SK21/AOG_RC/Help/Raven flowmeter pin out.jpg

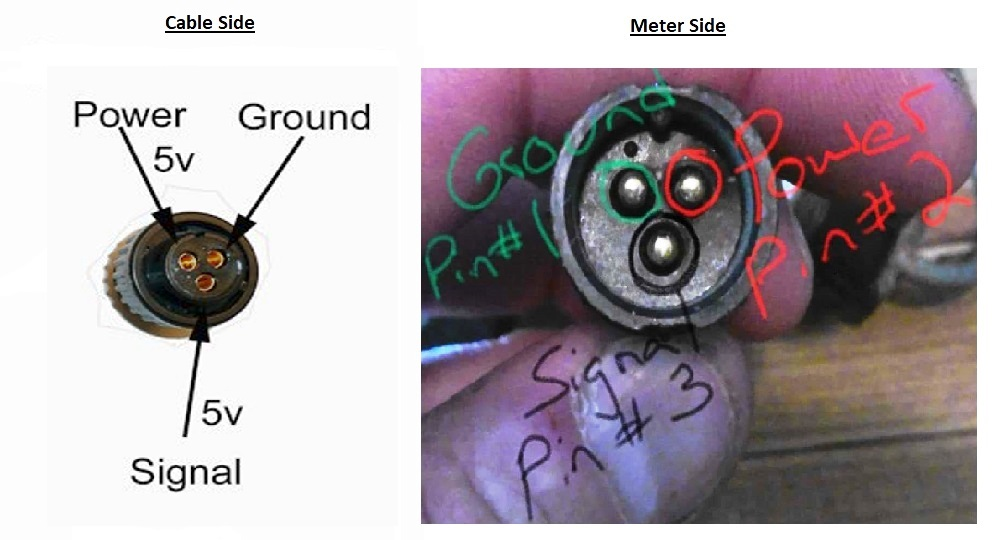
Help/Raven flowmeter pin out.jpg
