SK21/AOG_RC/README.md

RateController (RC) is an add-on app that works with AgOpenGPS (https://github.com/farmerbriantee/AgOpenGPS/) for product application rate control.

For more information see the Wiki.
