SK21/AOG_RC/Help/Schottky Diode/Notes.txt

Diode D2, LCSC# C116712

SS36 schottky diode in the power circuit has the anode end (+) to ground. 

cathode -     anode +
-----------|<-------
