SK21/AOG_RC/Help/Switchbox_PGNs.pdf

32618 32701
Switchbox to Rate Controller | Config from PCBsetup to switchbox

106 189

127 127

command | Auto
sw0 to sw7 | Master On
sw8 to sw15 | Master Off
CRC | Rate Up
Byte 2: | Rate Down
bit 0, - | Switches 1-16, bytes 7-22
bit 1, Master On | Work Pin
bit 2, Master Off | CRC byte 24

bit 3, Rate Up

bit 4, Rate Down

bit 5, Auto Section

bit 6, Auto Rate

bit 7, Work Switch
