SK21/AOG_RC/RateControllerApp/Help/frmMenuHelp.pdf

Troubleshooting
No Relays:

### 1. Is module config for board and relay type correct? 2. Subnet set in app? Uploaded to module? 3. Section count and width set? 4. Is Auto on? 5. Section assigned to relay? 6. Switch assigned to section?

7. If auto on, sensor counts/unit and base rate are needed.

No UPM:
1. Check speed.
2. Check working width.
3. Check sensor control settings.

### 4. AOG connected? 5. Module connected?

6. Check sensor counts/unit.
7. Check base rate.

### 8. Did the control values get sent to the module? 9. Control type, is it a valve or motor? 10. Connector fully plugged in? 11. Up to date version of module firmware? 12. Auto on?

No rate adjust:
1. In manual the master switch must be on.

### 2. Minimum pwm too low?

Motor won't shut off:
1. Minimum pwm should be 0.

### 2. Master override on?

After Updating firmware:
1. Resend subnet.
2. Resend module config settings.

Tips

- long press (right click) some screens, including the rate map, to drag to position. For the menu screen long press the icon in the top left corner.
- click on current rate to cycle rate display
- click on target rate to switch between target rate and alternate rate
- click on quantity to cycle quantity display
- click on quantity amount to reset
- click on coverage to cycle coverage display
- click on coverage amount to reset
- using the standard screen, click on AOG or MOD to minimize and display the rate only
- using the large screen, click on the graph to select a product
- on the options menu use ‘Single Product’ to arrange a minimal view of the large screen
