SK21/AOG_RC/RateControllerApp/Help/frmMenuJobs.pdf

Jobs

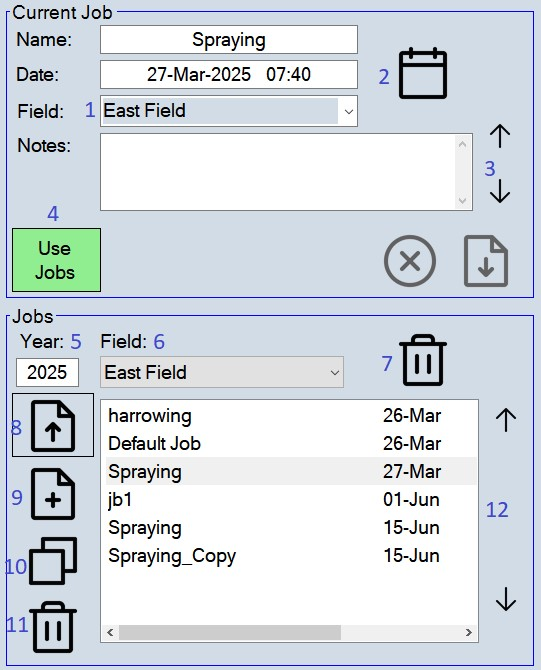
[picture p2: figure]

1. Field name. Select from list or type new name.
2. Insert current data and time.
3. Page up/down through notes.

### 4. If enabled allows the use of rate maps and storing

rate data.

### 5. Sort Jobs by Year 6. Sort Jobs by Field 7. Delete selected Field

8. Load Job.
9. New Job.

### 10. Copy selected Job information and rate map to a new

file.
11. Delete selected Job.
12. Page up/down through Job list.
