SK21/AOG_RC/RateControllerApp/Help/frmMenuPressure.pdf

Pressure

Take two readings to calibrate. Set to a known low pressure and enter the reading and the pressure. Do the same for a known high pressure. Enter the minimum reading for 0 pressure.

Press ‘Show’ to display the pressure screen.
