SK21/AOG_RC/RateControllerApp/Help/frmMenuConfig.pdf

Modules Config

### 1. Relays 0. no relays

1. GPIOs, use the micro-controller pins.
2. PCA9555, use 8 relay module.
3. PCA9555 , use 16 relay module.

### 4. MCP23017 5. PCA9685 6. PCF8574

### 2. Pins

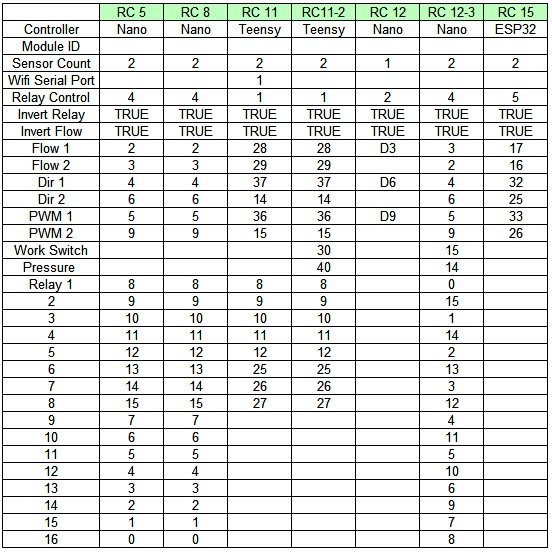
[picture p3: figure]

### 3. Nano Pins

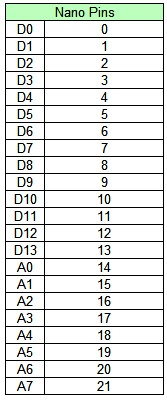
[picture p4: figure]
