SK21/AOG_RC/RateControllerApp/Help/frmMenuPrimed.pdf

Primed Start

Start a simulated product application or prime the booms when tractor is stopped. Using the switchbox master switch, hold in the ‘On’ position for the set delay time to enable primed start.

### 1. On Time

- Run-time for the application (seconds).

### 2. Speed

- Simulated speed.

### 3. Master switch delay

- The time to hold the master switch in the ‘On’ position to start the simulation (seconds).

### 4. Resume

- After the On Time finishes and if the tractor is moving continue with normal operation.
