SK21/AOG_RC/RateControllerApp/Help/frmMenuSwitches.pdf

Switches

### 1. On-Screen Switches

- Display on-screen switches.

### 2. On-Screen Dual Auto

- Display separate switches for auto rate and auto section control.

### 3. Work Switch

- Use a switch connected to the implement to control On/Off.

### 4. Auto Switch Rate + Sections

- Auto rate control and auto section control.

### 5. Auto Switch Sections

- Auto section control only.

### 6. Master Override

- Lock the master switch to on.
