SK21/AOG_RC/RateControllerApp/Help/frmMenuNetwork.pdf

Network

### 1. Rescan (circle)

### 2. Send subnet address to modules (up arrow)

The default values for each board can be loaded into settings.
