SK21/AOG_RC/RateControllerApp/Help/frmMenuRate.pdf

Rate

### 1. Product Name

### 2. Control Type

a. Standard Valve
- use a valve to vary rate
b. Combo Close
- use a valve to vary rate and on/off
c. Motor
- vary motor speed to control rate
d. Combo Timed
- use adjust/pause time for control

### 3. Quantity Units

- units used to measure product

### 4. Coverage Units

- Acre, Hectare, Minute, Hour

### 5. Sensor Counts/Unit

- sensor counts for each unit applied

### 6. Density

### 7. Base Rate

- application target rate

### 8. Alt. Rate (%)

- an alternate rate as a % of the base rate

### 9. Tank Size

### 10. Tank Start

- amount in tank at start of application
