SK21/AOG_RC/RateControllerApp/Help/frmMenuSections.pdf

Sections

### 1. Copy Button

- Copy width from section 1 to the other sections.

There are 16 sections to a module and up to 8 modules. Module 0 sections are 1-16, Module 1 are 17-32, etc. Sections can be defined individually or within zones. All sections in a zone are the same width. All sections in a zone are controlled with one switch. AOG can still auto control each section individually.
