SK21/AOG_RC/RateControllerApp/Help/frmMenuRateData.pdf

Applied Rates Data

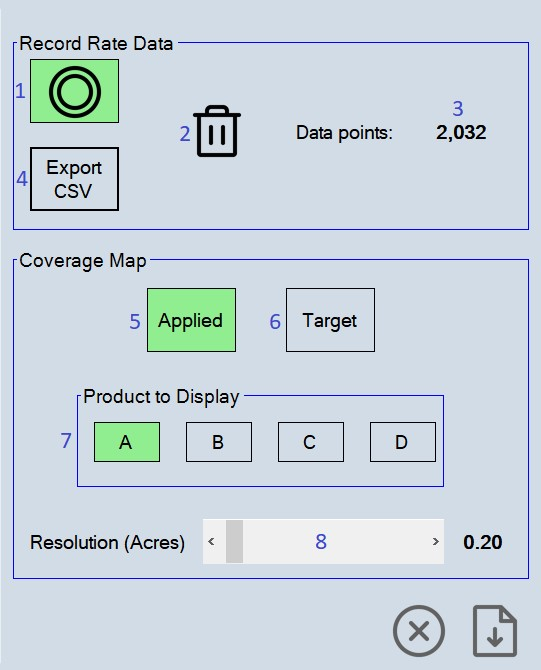
[picture p5: figure]

1. Enable recording.
2. Delete recorded data.
3. Number of data records saved.
4. Copy rate data to a file.
5. Show Applied rates on map.
6. Show Target rates on map.
7. Choose product rates to show on map.
8. The size of the area to average the rates in acres or hectares.
