SK21/AOG_RC/RateControllerApp/Help/frmMenuRateMap.pdf

Rate Map

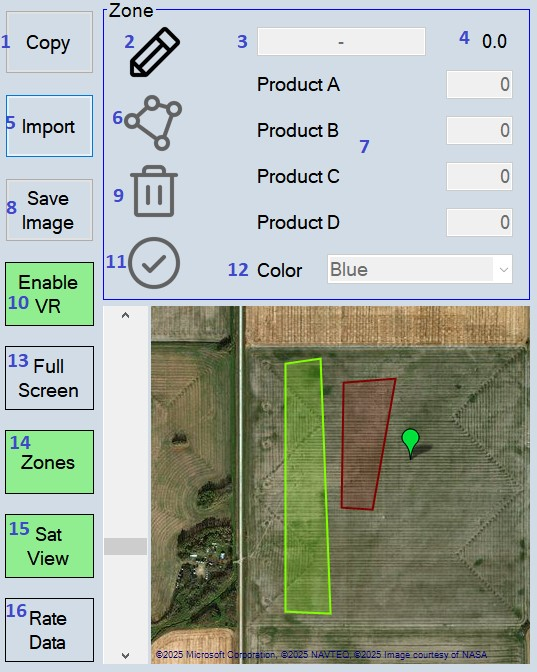
[picture p6: figure]

1. Copy rate map from another job.
2. Edit rate zone.
3. Name of zone.
4. Area of zone in acres or hectares.

### 5. Import

- Press the Import button to open the Import form. Load an alternative type of shape file using the up-arrow on the Import form. The form will list the RC attributes on the left. Use the drop-down box to the right of each RC attribute to cross reference from the alternative file attributes. Use the down-arrow on the Import form to save a new RC shape file with these cross referenced attributes.
6. Edit polygons.
7. Product rates.
8. Save an image of the map to file.
9. Delete zone.

### 10. Enable VR

- Enable variable rate control. Each product uses variable rate control. All zones must define a rate for each product used.
11. Save zone edits.
12. Zone color.
13. Full screen view.
14. Show zones overlay.
15. Show satellite view.
16. Show rate data overlay.
