SK21/AOG_RC/RateControllerApp/Help/frmMenuProfiles.pdf

Profiles

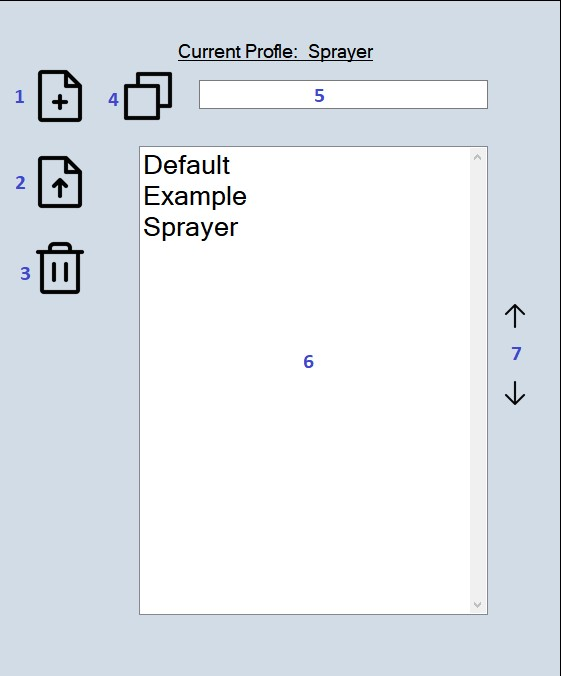
[picture p7: figure]

1. New | 2. Load
3. Delete | 4. Copy
5. File name for New/Copy | 6. Files to select
7. Page Up/Down
