SK21/AOG_RC/Help/MCP23017_Pins.PNG

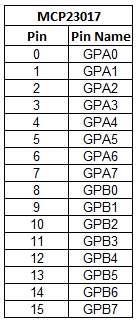
Help/MCP23017_Pins.PNG
