SK21/AOG_RC/Help/Schottky Diode/C116712.PNG

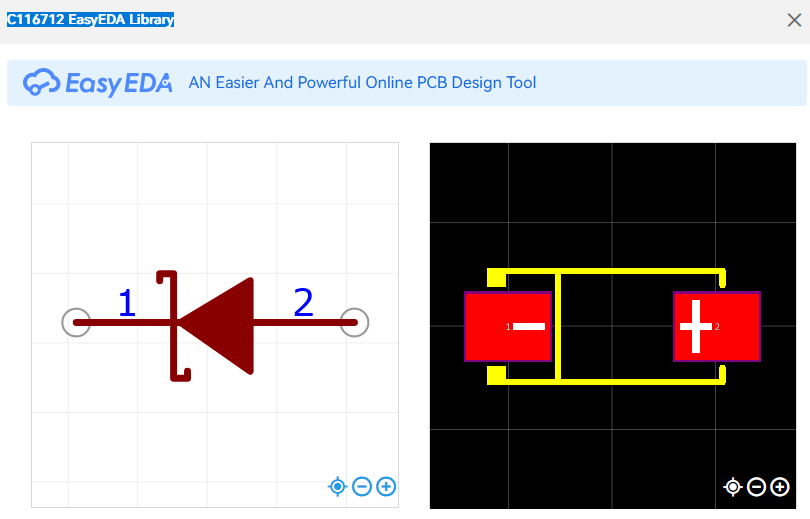
Help/Schottky Diode/C116712.PNG
