SK21/AOG_RC/Help/Schottky Diode/Circuit.PNG

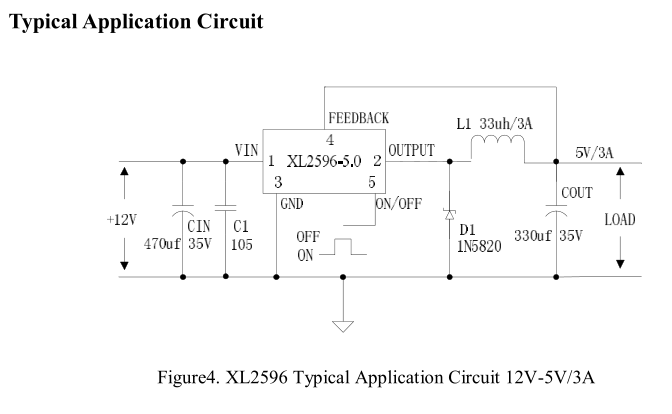
Help/Schottky Diode/Circuit.PNG
