SK21/AOG_RC/Help/Schottky Diode/SS36.PNG

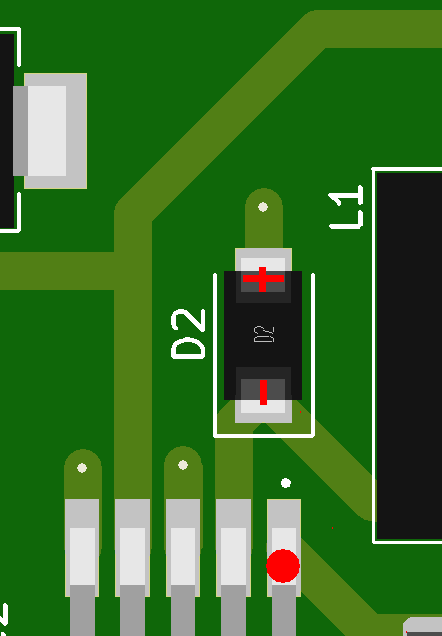
Help/Schottky Diode/SS36.PNG
