SK21/AOG_RC/RateAppSource/RateController/Resources/2wire.png

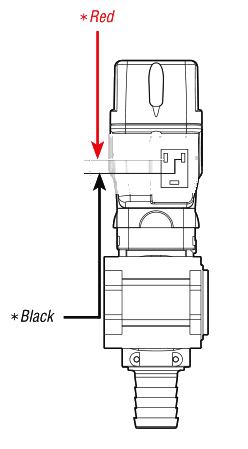
RateAppSource/RateController/Resources/2wire.png
