SK21/AOG_RC/RateAppSource/RateController/Resources/3wire.png

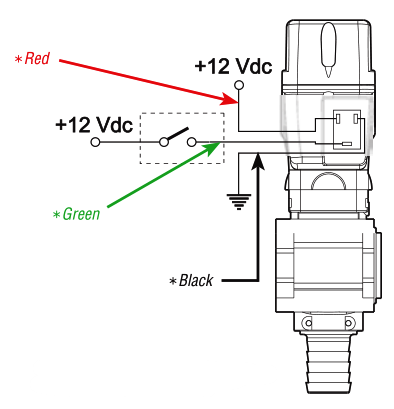
RateAppSource/RateController/Resources/3wire.png
