SK21/AOG_RC/RateAppSource/RateController/Resources/Pins1.PNG

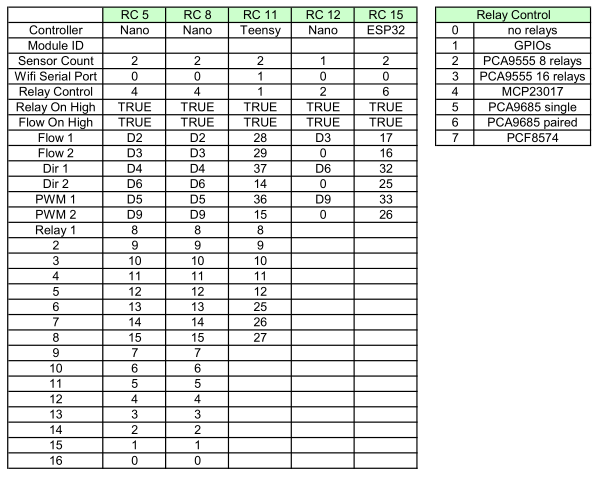
RateAppSource/RateController/Resources/Pins1.PNG
