SK21/AOG_RC/RateAppSource/RateController/Resources/Pins.PNG

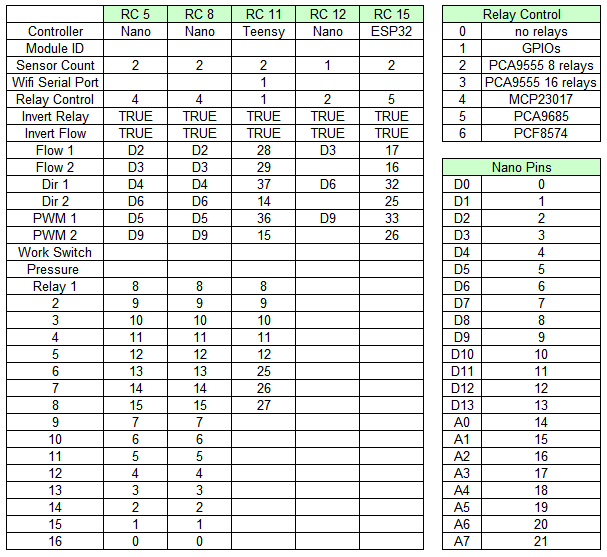
RateAppSource/RateController/Resources/Pins.PNG
