SK21/AOG_RC/RateAppSource/RateController/Resources/Valve2wire.png

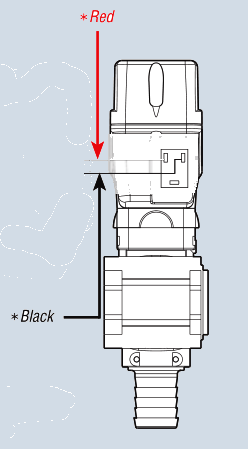
RateAppSource/RateController/Resources/Valve2wire.png
