SK21/AOG_RC/RateAppSource/RateController/Resources/Valve3wire.png

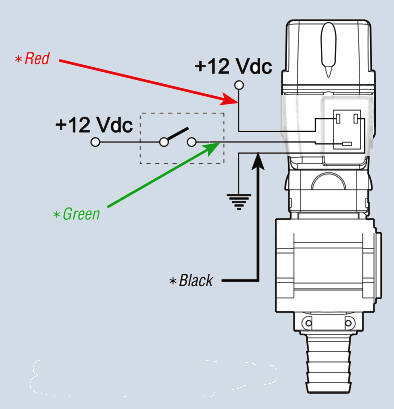
RateAppSource/RateController/Resources/Valve3wire.png
