SK21/AOG_RC/RateAppSource/RateController/Resources/x-bold.png

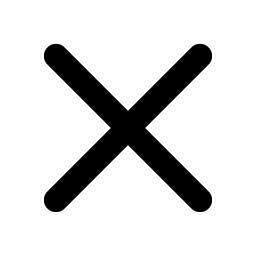
RateAppSource/RateController/Resources/x-bold.png
