SK21/AOG_RC/(threads)

Thread 1 (2020-02-13):

Broken link

ikidd, 2020-02-13:
Reorg of folders broke the links in your ratecontroller repo.

SK21, 2020-02-13:
Ok I'll fix it.

Sent from my BlackBerry — the most secure mobile device — via the SaskTel Network
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

Closed 2020-03-23.

Thread 2 (2021-01-30):

Restructure repository

mirh, 2021-01-30:
Can you purge all the binaries from git, and just attach them cleanly and neatly in the release section (bundled together or separately)?
Putting aside they make sources quite heavier, even if you half-way understand their working it's a mess to go back and forth between their folders.

SK21, 2021-01-31:
I can see where it is 'heavy'. I just downloaded the zip file. It is over 100 MB. So what your saying is to create a release and move the supporting files to there. Then just the updated install can be downloaded. The supporting files can be downloaded separately if needed.

mirh, 2021-01-31:
And move the binaries to the release section, yes.
I'd also recommend to bring in the [.gitignore](https://github.com/farmerbriantee/AgOpenGPS/blob/master/.gitignore) file from aog to avoid "forgetting" stuff when pushing.

Btw is "100" and "200" supposed to be a version number, or what?

SK21, 2021-02-02:
Yes a version number.

marshalab, 2021-02-03:
Sorry for the stupid question. I'm a newbie trying to figure out a lot of forks AgOpenGPS.
And where are the device diagrams for your development? Or is iron described elsewhere?

thanks

SK21, 2021-02-05:
Any of the pcbs will work with RateController. The 10 pin network header on RC4 needs more 3.3V current than the nano can provide. The nano clone here might work. https://www.seeedstudio.com/Seeeduino-Nano-p-4111.html A better option may be to use a Nano ethernet shield if you are connecting that way.

mirh, 2021-02-05:
Cool.
Would it be possible to get some logical schematics like [this](https://github.com/Coffeetrac/AG_Rate/blob/master/AGRate_Schematics.jpg) or [this](https://aws1.discourse-cdn.com/free1/uploads/agopengps/original/1X/199a6c959acedecaec6603bb8612be2a2adf76c6.jpeg)?

I'm not sure what I need in addition to arduinos, a flowmeter and the controllable valve/PID controller

SK21, 2021-02-06:
Here are some schematics.
[RC schematic.pdf](https://github.com/SK21/AOG/files/5937063/RC.schematic.pdf)
[schematic.pdf](https://github.com/SK21/AOG/files/5937065/schematic.pdf)
[AOG schematic.pdf](https://github.com/SK21/AOG/files/5937066/AOG.schematic.pdf)

mirh, 2021-02-06:
Thanks, that was really helpful! (even though still not the same cakewalk of the normal dokuwiki instructions for autosteering)
I only need the motor driver then now.

Why is there a capacitor on the flow input trace though? My plan was just to connect the spare components in a fancy box without the pcb.

SK21, 2021-02-06:
On one tractor I found a lot of noise on the signal. The capacitor seemed to clean it up.

mirh, 2021-03-09:
Uhm, well, now the repo is quite cleaner. Thanks.
Is there any way to control a "master" machine switch though?
It seems wasteful to turn off all sections independently when you get at the end of every line.

Closed 2021-03-09.

Thread 3 (2021-03-07):

RC4 PCB and parts lists?

ikidd, 2021-03-07:
I think I've looked through everything, but can't find the PCB sections and the parts lists?  Am I just blind?  In another copy of the repo I have a top level folder called RateController100 with them inside, but I was checking if there were any changes to what I have and can't find anything in the current version of the repo.

SK21, 2021-03-07:
You can find it under releases, version 1, other files. There is no changes to rc4.

Sent from my Galaxy

-------- Original message --------
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

joshwilsonfarms, 2021-04-01:
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
Is there anyway to incorporate rate control in to my section control system without using the PCB you have listed?

SK21, 2021-04-16:
You would just have to change the pin assignments to match your setup.

Closed 2021-05-03.

Thread 4 (2021-04-15):

Use without I/O extender?

mirh, 2021-04-15:
I have a nano, and a board with 8 DPDT relays (and I should only need 5 of them).
Is it possible you could add a switch case or alias to the mcp functions, to use the normal pinMode/digitalWrite optionally?

(btw, for maximum noobproofness, I guess you could even add a comment on line 80 of RCarduino.ino to point out that in case of error users should download the right library from the manager in the arduino ide tools section)

SK21, 2021-04-16:
I can add code to use RCarduino without a I/O extender.

mirh, 2021-04-16:
Cool, thanks.
I have more questions than answers though now.

Why did you switch to the analog pins?
And why only 4?

SK21, 2021-04-16:
The analog pins are the same as digital pins. If someone is using a ethernet shield those pins are not being used. The ethernet shield uses pins 7,8,10,11,12,13. You can change it to whichever pins are free.

SK21, 2021-04-16:
Pins A6 and A7 are input only and won't work for relays.

mirh, 2021-04-16:
Right, I see the comment.
Though now, something else is escaping me.

With your vanilla code, I'm getting relays at D2, D3, D4 and D6 to turn on, and I cannot seem to do anything else with the thing.
If I adjust the code for Relay# to go from 2 to 9, I only get D4 and D6 to light up, and again I cannot seem to toggle them.

Once put aside my lack of control, the FlowDir array seems to be the deciding factor... But I'm not sure how I'd be supposed to control n sections when the code (even for the MCP23017 case) has just two pins there.
Sorry if I'm making overly dumb questions.

SK21, 2021-04-17:
For  FlowPin, FlowDir, and FlowPWM, the first element of each array is for one product. The next element of the array is for another product. For the first (or only) product the first element of the FlowPin is connected to an interrupt and senses the flow. The FlowDir and the FlowPWM are connected to the motor controller to open or close the control valve.

How are you turning on the relays? Are you using the RateController app? Might be a setting in that.

mirh, 2021-04-17:
Duh, right. I hadn't completely configured RateController, and it wasn't working. Or maybe it was just that (*understandably*) I had to \*move\* the tractor in the simulator for the section switches to turn on at all.
I still have a couple of remarks though:
* it should be pointed out that AgIO has to be kept open for RC to hook it (it may be obvious when it's AOG to handle the machine port, but given here the serial port doesn't have to be hooked there, it's confusing)
* I can [half-way](https://github.com/SK21/AOG/blob/2.1.3/RC%20Source/RateController/FormStart.cs#L209-L218) guess what that salmonish "SimColor" hue for *Mod* means, but if I were out there in the field I could hardly see that shade (let alone figure out if it's just an innocent warning, or something I should quite be worried about)
* just to check, is it normal switching to "fast close valve" has D5 and D6 always turned on, while switching to "motor" has only D6?

SK21, 2021-04-17:
AOG only connects to AGIO, so yes AGIO needs to open. But then to use AOG, AGIO needs to be open anyway.

In the field the simulator should be off, so Mod with be either red or green. Also in the product detail the heading shows if it is in simulation mode.

If D5 and D6 are for relays, changing the valve type shouldn't affect whether the relays turn on. Make sure D5 and D6 aren't assigned to anything else such as PWM or DIR.

mirh, 2021-04-17:
Makes all sense now, after seeing the SensorCount loops I think I got the point of the arrays arranged this way.
Thanks very much.

mirh, 2021-04-20:
Ok in retrospect I don't think I have actually understood them.

I only have one sensor.
But I can't only write a single pin for flow and pwm in the arrays, because SensorCount is 2.
And if I lower it to 1, then hell break loose across many files.

I can easily see the 0s and 1s with arduino's [InputPullupSerial](https://www.arduino.cc/en/Tutorial/BuiltInExamples/InputPullupSerial) example on D3, but I cannot get ratecontroller to understand it.

Closed 2021-04-17.

Thread 6 (2021-04-28):

Program is dead without AOG

mirh, 2021-04-28:
So.. after much tinkering (somehow, I had completely missed we are working on baud 38400) I got to read your program data inside the arduino IDE.
The problem is I'm only getting `127,101,0,0,0,0,0,0,0,0` or `127,101,1,0,0,0,0,0,0,0` as returned values, forever.
Do I need to use RateController to have actual feedback back?

And even then, am I supposed to do anything else besides setting simulation to off?
I tried to connect my flow meter to either of the FlowPins (that I checked to get the correct signal with a simple code sample), but no matter what I do, calibration never senses a single count.

SK21, 2021-04-28:
You need RateController for the ino to work. Set simulation off. If you are connecting with serial use one of the connections on the comm page. The green light should come on.
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

Also the Mod indicator should turn green.

On the Products/Options for the product you are using the Module ID and Sensor ID should be 0. The indicator should be green.
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

The Products/Diagnostics tab will show any flow signals as UPM Applied. The tractor will have to be moving and sections turned on. Make sure the sections widths are entered again in RateController even if they are already entered in AOG. Make sure on the tab Products/Options the sections you are using have a check mark.

On the Products/Rate tab the Sensor Counts/Unit needs to be entered. Whether you use VCN or PID press the Load Defaults button.

mirh, 2021-04-29:
:\
Everything I had to do was opening AOG, not even the tractor moving, and it works now.

...

I get why a lot of things requires the main program open, but why is that also "hard blocking" of UPM applied and sensor counts?

SK21, 2021-05-01:
Yes that could be done as well.

SK21, 2021-05-02:
Have you tried receiving the pulse counts without AOG?

mirh, 2021-05-03:
Yes, that's what I was banging my head against in the first post.

SK21, 2021-05-03:
See if it works now.

mirh, 2021-05-15:
Perfect now, thanks!

Closed 2021-05-15.

Thread 7 (2021-05-01):

Relay control over serial?

mirh, 2021-05-01:
Sigh, I can't understand if I'm always here complaining because I'm one of the few people that got at least half-way of training in both AG and ICT, or if I'm just a bane of intelligence.

How are you supposed to control relays from AOG, if RC takes full ownership of it?
I mean, I see the code to control them is there, but nothing triggers when I click on the various sections.

Or is this only a limitation I brought upon me when I decided USB/serial was good enough for me?

SK21, 2021-05-02:
Serial and UDP work the same. If you mean controlling the sections with the on-screen buttons of AOG, then yes these should work. The sections should be able to be controlled from either the on-screen buttons or from remote physical switches. If you have physical switches that are turned off, these take precedence to make sure sections stay off. If you don't have physical switches then it is set to auto mode where the on-screen buttons should work.

SK21, 2021-05-02:
The on-screen section buttons previously only worked in RC auto mode. They now work in manual mode as well.

mirh, 2021-05-03:
***Well***
I'm glad you found a potential bug (I didn't notice it)
But it turns out I had just forgot I had stolen the +5V/GND cables from the relays to power the flowmeter. 😓

Closed 2021-05-03.

Thread 9 (2021-07-30):

Some hardship on adding more relays

mirh, 2021-07-30:
Soo.. As usual I'm with my Nano, connected with a simple usb cable.
Everything was fine and dandy, until I tried to go past the 4 relays that the "Nano pins" codepath defaults to.
I uncommented the pinMode for Relay5 to Relay8, then same for their defines, and last but not least I set them to follow the natural progression from A4 to A7
But for some reason I can still only control the first four usual relays (and yes, I did set 8 sections in both RC and AOG)

---
p.s. I also found great.. puzzling when it came to interpreting this line.
https://github.com/SK21/AOG_RC/blob/f1fbfcb5fb170020fd8f94c0bf1c1fda9da2faf9/RCarduino/RCarduino.ino#L28
Could it be named to something like *UsePhysicalSwitches*?  Also, the comment could maybe be changed to "1 to use commands from hardware switchboard"

SK21, 2021-07-30:
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

Did you set the switch # for each of the other sections? Do you have 8 switches? If not one of the existing switches that you have can control some of the new sections.

I don't think A6 and A7 will work. They are input only on a Nano.

Line 28 attempts to clarify whether the switches used to control the sections are connected (local) to the rate PCB or are the switches on a separate pcb dedicated to switches or the sections are controlled on-screen. 0 means no switches connected to the rate pcb. 1 means switches are connected to the rate pcb.

SK21, 2021-07-30:
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

Also need to uncomment lines 35 to 38 of the Relay.ino

mirh, 2021-07-31:
Perfect, that was it!
(I wonder if it couldn't be made a bit more obvious? perhaps already just with a comment)

> Line 28 attempts to clarify whether the switches used to control the sections are connected (local) to the rate PCB or are the switches on a separate pcb dedicated to switches or the sections are controlled on-screen.

Yes, I had eventually imagined you were aiming for something like [this](https://www.youtube.com/watch?v=kI321iBwe4U) or [this](https://www.youtube.com/watch?v=K2U5_X6FHQg).
It's just.. I don't know, that wording isn't the clearest label on the shed.

Closed 2021-07-31.

Thread 10 (2021-08-18):

Relay-controlled valve

mirh, 2021-08-18:
Long story short, my flow valve has a motor that works with polarity reversal.
And through the power of DPDT switches, we could just say it has two commands/states: "more" and "less".

I tried to half ass together something in *Motor.ino*, but clearly there's so much more to it.
Would it be too hard and disruptive to add support for this?

SK21, 2021-08-18:
Are you using the motor option or the standard valve?

mirh, 2021-08-18:
I tried to tinker with the standard valve code, after having retooled the PWM pin to be just a digital one outputting the opposite of the direction state... but it kinda failed.
But I think this would be worth a new type of motor tbh (is "proportional" even the right word? I have no control on the velocity, maybe "linear valve" would be better?) since nothing in the PID settings tab would apply.

SK21, 2021-08-19:
I am not clear on how your motor works. A standard valve has more and less commands. The motor control varies the voltage from 0 to 12 v.

Do you have a model # or link to a page about the motor?

mirh, 2021-08-19:
I have [this brochure](http://www.bertolinipumps.com/irrorazione_accessori/cp_mot.pdf#page=2) (last one) about the body, and [this](http://www.bertolinipumps.com/prodotti/cataloghi/catalogo-multiduplospray.pdf#page=2) should be the valve-only.

> A standard valve has more and less commands.

Yeah, but you also have PWM to regulate speed, while "effect direction" is the state of a single relay.
Here instead, you just supply +12V or -12V (which at the end of the day I made to correspond to two separate relays) and that's about it.

SK21, 2021-08-21:
In the last brochure about the valve it looks like the motor only controls on/off, not flow.

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

mirh, 2021-08-21:
It's on/off in a sense, yes.
But the "obturator" can end up sitting in more than just two states, if I can explain.
And this way (since polarity reversal makes for *two* separate "ON" eventually) you can control flow.

bduncan175, 2021-09-17:
It sounds like his valve is similar to a standard raven flow control valve that is plumbed as a bypass system, but can also completely shut off. https://www.spraysmarter.com/raven-precision-1-poly-control-valve-flanged.html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

mirh, 2021-09-17:
Sorry, I snafued the valve brochure. [This](http://www.bertolinipumps.com/prodotti/cataloghi/catalogo-serieviking.pdf#page=1) should be the right one.
To reiterate again: with +12V (i.e. one relay) the ball rotates in one direction, with -12V (an other relay) the opposite one.

SK21, 2021-10-04:
So you would like to control the pressure with 2 relays, one for increase and one for decrease? A motor controller would not be used. I could change the code to add another control type that would use relays instead of a motor controller.

Motor.ino:
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

SK21, 2021-10-04:
Should be:

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

SK21, 2021-10-05:
It could also work with a motor controller if the PWM is set to maximum. This would give 12V.

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

mirh, 2021-10-07:
> A motor controller would not be used.

I think the confusion is due to the valve mechanism technically having one, but the DPDT wiring I used making it logically be just two switches (I mean, I'm not sure how else I could have controlled polarity inversion otherwise).

***Anyhow***
```C
// use 2 relays for flow control
if (FlowEnabled[i])
          {
              if (pwmSetting[i] > 0)
              {
                  // increase
                  digitalWrite(FlowDir[i], 1);
                  digitalWrite(FlowPWM[i], 0);
              }
              else if (pwmSetting[i] < 0)
              {
                  // decrease
                  digitalWrite(FlowDir[i], 0);
                  digitalWrite(FlowPWM[i], 1);
              }
              else
              {
                  // no change
                  digitalWrite(FlowDir[i], 0);
                  digitalWrite(FlowPWM[i], 0);
              }
          }
          break;
```
was exactly what I needed (at least when I replaced the fast close valve block for testing purposes).
The only thing is.. since this has no derivative control, at least when near the target rate shouldn't you have some kind of margin of tolerance to not flip-flop forever the relays?

mirh, 2021-11-01:
Thank you so much!
With combo close now everything is just right (I still have some idea for target rate adjustments on-screen buttons, and hooking the "master valve", but that will be for another time I guess)

Do you accept donations by any chance?

mirh, 2023-04-12:
Ok well, I quite literally just re-repeated the code above and it worked this time.
If the merit wasn't to be with some of your latest commits, I suppose it could be with me possibly having mixed up the pin numbers due to the different order the original lines have.
https://github.com/SK21/AOG_RC/blob/feeb3e6a7ddbb1c69c3beb8bc7b5be15e5b7a55b/Modules/Nano/RCnano/Motor.ino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
The only "novelty" is that I also have to remember to set _PWM maximum_ to 255.

mirh, 2023-04-29:
I don't know if this couldn't be an offshoot of #30, but as if it wasn't enough I cannot get the Every Nano to respect that
```
  // no change
  digitalWrite(Sensor[i].DirPin, 0);
  digitalWrite(Sensor[i].PWMPin, 0);
```
bloody code.
Once the pin turns on once, it doesn't shut up until I disconnect the communications (or well, I enable auto mode *\_-\_*).

mirh, 2025-04-27:
I'm once again in need of a hand with this more/less valve.
Ever since 2.3.6~2.3.7 (I'm gonna guess due to the different way the deadband and other calculations were changed?) the relay that should increase the flow rate keeps staying on even when the implement is turned off.
And starting from 3741da803d9b6d49f46cb74d0c5ecd4aff446a49 it's instead just dead.

Thread 11 (2022-02-02):

Extra headers aren't optional

mirh, 2022-02-02:
https://github.com/SK21/AOG_RC/blob/fe67227c4d8c57f762458e546be5b60ef9889aad/RCnano/RCnano.ino#L1-L2

Of course they wouldn't be needed when you are just using the arduino pins, and when you aren't using udp, respectively.
(yes it's a miserably small issue since you can just delete the two lines, but still)

SK21, 2022-02-03:
I don't believe they cause that much trouble if left included. They could be commented out if necessary.

mirh, 2022-02-03:
I was thinking you could put the includes below the user settings, and guard them with ifs, but I guess it's a pedantic trifle.

Closed 2022-02-03.

Thread 12 (2022-02-02):

Master valve support

mirh, 2022-02-02:
I didn't really want to bother you with yet another "personal customization" request, but I just noticed `UseSwitchedPowerPin` seems kinda half-way it already.
You would only need to move it from "per whenever the system boots up" to "per actual usage" (i.e. whenever there is at least a section turned on)
This would be particularly helpful wear-wise, so when you reach the end of the crops row or when you manually toggle all sections, you don't have to "strain" n-th relays and valves but just a single one.

SK21, 2022-02-03:
As it was originally intended this change would not work correctly. This could be implemented on a per user basis. The code could be modified to fit your needs.

mirh, 2022-02-03:
What was the original purpose then? Something other than pulling open some master switch?

SK21, 2022-02-04:
It was to provide power for the rate control valve.

mirh, 2022-02-04:
Oh, I see, as opposed to a valve where control and power are on the same line. Sorry.
Well then, my feature request still stands.

Whenever work is being done you would have such relay enabled, and when an "action" would entail that no section is powered anymore you just leave them alone, and instead toggle this.

SK21, 2022-04-09:
In the Dev branch the Rate App will now do Master relay. On when sections are on, off when all sections are off and the section relay aren't moved.

mirh, 2022-05-08:
Sorry for the delay.. lots of bad stuff going on.
But I'm quite lost with the new rewrite of the arduino sketches (I can sense perhaps you wanted to simplify/unify the MCP/nano-only cases, but comments seem skewed just for the former now).
Where would I even specify the "master relay"? I don't see any such entry in the PCBpinConfig struct, nor I could spot any code designed for this functionality.

p.s. as I already said plenty of times, please add [some](https://github.com/github/gitignore/blob/main/KiCad.gitignore) [gitignore](https://github.com/github/gitignore/blob/main/VisualStudio.gitignore) to the project. The repository is just so heavy.

SK21, 2022-05-14:
Master relay is set in the rate app under the menu option relays. On the relays page you choose the type of relay. Section, slave, master, power or Invert_Section.

mirh, 2022-09-20:
Ok sorry again.. When I found new time for tinkering, I eventually had instead to debug some big annoyance with AOG itself.
What to say then?

Your PCBsetup app is pretty nice, but I have been banging my head for a day about what I should do for RC to work.
Should I upload with the arduino IDE the sketches in the modules folder as usual? Is PCBsetup supposed to take care of that too? Is the whole design even supposed to work with just a bare Nano?
Because no matter what I tried, the `Mod` indicator doesn't light up.

I know something ***is*** happening because every time I connect or disconnect from the Comm window, I can hear the relays clicking.. But red colour doesn't seem good.
Btw the monitor in your test app gets stuck at "tarting I/O Expander" (sic.)

SK21, 2022-09-22:
Is it the timing in AOG that you had to debug?

PCBsetup can load the firmware and the settings. It is meant to be used instead of an IDE, so no knowledge of programming is required. The IDE can be used if preferable.

I just erased a Nano with a blank sketch. Then I used PCBsetup to upload the Nano rate firmware. It showed fine in the serial monitor.
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

I connected the Rate App to the Nano comm port, ran AOG and started a field. Mod turned blue and then green. Blue indicates the module is sending but not receiving.

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

Have you tried uploading the Nano rate firmware? You may need to switch bootloaders.

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

mirh, 2022-09-22:
> Is it the timing in AOG that you had to debug?

https://github.com/farmerbriantee/AgOpenGPS/issues/264

> Have you tried uploading the Nano rate firmware? You may need to switch bootloaders.

I also did that.
*Modules* with the IDE, the default from pcbsetup, and even the latest .ino.hex from *Resources*.

It doesn't change anything.
In serial monitor, I only see `RC Nano : 17-Jul-2022` (every time) and then once every n attempt, there's some random part of the string "Starting I/O Expander".

Btw when I tried "use old bootloader" it almost seemed like I had bricked the arduino, and I could only recover from the IDE.

SK21, 2022-09-22:
I am not sure what else you can do. Does uploading the "Blink" sketch from the IDE examples work?

mirh, 2022-09-22:
:\\
No? I don't have any wemos (or pcb for all that it matters).
Where is that even mentioned? And why would ethernet be required even if the corresponding button isn't selected?

SK21, 2022-09-22:
The wemos on the pcb connects to Nano rx/tx. These pins are also used by the usb connection. The ethernet shield doesn't use rx/tx so there is no conflict.

If you don't use the wemos then there can be no comm conflict.

mirh, 2022-09-23:
"Comm" is just fine indeed (be it in the namesake RC window, or the two green lights in pcbsetup).
I don't have any wi-fi or ethernet, I'm not getting conflicts.
I just have literally a Nano and a straight usb cable to pc. Is this not supposed to work anymore?

SK21, 2022-09-23:
Yes usb will work. I just tried it in the previous posts. Just a nano and a usb cable.

mirh, 2025-04-27:
Since 3.7.9, when I stop the sections (that is, all of them together like with the button in AOG) rather than just the master relay turning off, every single one of them switches.

Closed 2023-02-26.

Thread 15 (2022-09-25):

PCBconfig struct needs extra member for Nano to work

mirh, 2022-09-25:
So.. Proceeding from https://github.com/SK21/AOG_RC/issues/12#issuecomment-1256272563, I found out eventually that if I add back `uint8_t CommType = 0;` (even to the latest master) I can finally get some output at last.
With some tinkering I ascertained that the name or the value don't really matter (obviously, it's not like the thing is still used somewhere), the magic trick is just adding "something".

    101,127,16,0,0,0,0,0,0,0,0,0,244

`lbArduinoConnected` is still red then to be fair, but I didn't really followed through considering the big mystery that this nightmare bug is.

SK21, 2022-10-01:
What kind of output are you getting?

mirh, 2022-10-01:
The one in the preformatted code block (repeated over and over again as you would expect).
Previously I was just getting the InoDescription line and then nothing else.

SK21, 2022-10-03:
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

For something to try change line 157 to some other number than 2388.

SK21, 2022-10-04:
So it must have been old data in the eeprom from a previous version that caused the problem. Changing the identification # for the data causes setup to use the default values instead of the ones in the eeprom. Then these default values are saved to the eeprom.

mirh, 2022-10-05:
Daamn... it's really facepalmy that it wasn't a905b8e1699570078a962c9ac47ed35eb792e4f3 to break everything then.
Yet again thank you (maybe you could change the identifier from time to time)

mirh, 2023-02-18:
Ok so.. Good that you actually seem to update it each time you update the code.

But  is it normal that every single time I use PCBsetup to update the firmware.. the damn thing goes haywire (i.e. you can see serial monitor spitting out garbage or half-lines) and only if I upload the inos with `InoID` manually changed I can get anything done?

SK21, 2023-02-18:
Which previous ino did you have loaded in the nano? Could you send me it so I can try to reproduce this problem?

mirh, 2023-02-18:
At least going all the way back to a year ago, I have never used inos other than your own on my nano.
And honestly this has been happening for every version since the introduction of PCBSetup.

Not that I'm unhappy now (after taking two whole weeks in https://github.com/SK21/AOG_RC/issues/12#issuecomment-1255446847 and following, if you remember) just knowing that I need some elbow grease to compile the code to get it setup.
But still, it's bewildering that the eeprom just cannot seem to behave.

To sum up again: if I load the firmware with PCBSetup I can only get garbage in return.
If I load [this](https://github.com/SK21/AOG_RC/tree/master/Modules/Nano/RCnano) from the IDE (and god forbid I didn't change the identifier, at least after having tried with PCBSetup) all is relatively fine and well.
...
Is RateNE_ino.hex even rated to work in the PCB-less case? ([this](https://github.com/SK21/AOG_RC/blob/69834b8d2abaa0395d5aceaf03d6fdc9e44f863d/PCBsetupSource/PCBsetup/Forms/frmAbout.resx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) line seems particularly suspicious tbh)

SK21, 2023-02-18:
I can't reproduce your problem. I have loaded the Switchbox firmware from PCBSetup and then loaded the Nano rate firmware. They both work. The ide should work fine and change the InoID to be sure there are no problems with the eeprom values.

RateNE will work with a bare Nano, no pcb.

Thread 21 (2023-02-18):

Puzzling relay situation

mirh, 2023-02-18:
So, long story short (hoping this is not related to #15?) I have this Nano with relays connected to the analog pins.
Since PCBSetup expects the digital pins codes, I set Relay1 to Relay5 the numbers from 14 to 18.

...
This doesn't seem to do anything no matter what I did in RC.
After desperately adding 16 sections to my virtual sprayer in AOG, I figured that the physical relays finally came to life when I went to control section 9 to 13 (which under the default RC settings are assigned to Relay9 to Relay13).
And for the life of me I cannot understand what's happening (putting aside that for the moment I'm not even caring for the flowmeter).

Could it be that [last year](https://github.com/SK21/AOG_RC/commit/a905b8e1699570078a962c9ac47ed35eb792e4f3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) you dropped the vanilla Nano pins assignment table?

SK21, 2023-02-18:
There was an error in the relay code. It is fixed now.

SK21, 2023-02-26:
Can you give me an example of the glitchy buttons.

mirh, 2023-02-26:
Their images are missing. You can still use some of the settings, but opening products will crash the application.
Again, this should be easily reproducible if you just compile release (I was targetting VS 2022 and .NET 4.8 but I don't think it matters).

SK21, 2023-02-26:
I am using vs 2022 and .net 4.7.2.   Again I can't reproduce your results. No images missing, no crashes.

mirh, 2023-02-27:
Well.. I'm not able to reproduce it either.
I guess it's still a bit funny that I can compile it even though I did uninstall 4.7.2 (and I didn't retarget anything) but whatever.

Closed 2023-02-27.

Thread 22 (2023-03-19):

RC is dead when base rate is astronomical

mirh, 2023-03-19:
Because of reasons (likely related to my going back and forth between new and old versions, but idk really) my base rate just so happened to go out of bounds. Like in the hundreds of thousands or millions.
Nothing crazy or noteworthy by itself, except for the part where (until I reset it back) no signal seemed to be sent out to my relays.

Of course wrong inputs could only lead to wrong behaviour, but "nothing happens" seems relatively insidious to track down to this.
I suppose you could add extra drippy validation in the *Product* page too, but the proper fix should probably go towards whatever glitchy code that parses/handles `lgBaseRate` further downstream.

p.s. in somewhat related news, where did *deadband* go after 2.3.7?

SK21, 2023-03-19:
I have updated the code to add extra checks for rate validity.

Deadband is fixed in code and could be edited there.
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

mirh, 2023-03-19:
> I have updated the code to add extra checks for rate validity.

I was expecting whatever case of overflow getting either the app or the board stuck to get handled, but I guess I'm not the sharpest tool in the shed here.

> Deadband is fixed in code and could be edited there.

I had a suspect about that, but why is this even the case now?
Like, if I didn't have a [reference](https://discourse.agopengps.com/uploads/default/original/2X/7/730bb55ac1352db311d1470141d659181b91da9d.jpeg) from the old UI I wouldn't even know what kind of unit its value is in.

mirh, 2023-03-22:
I can confirm it seems to be switching between the new RC and the one in 2.1.13, to absolutely send values to the sky... even though which ones get affected is somewhat random for some reason.

mirh, 2024-07-22:
Happened again between 2.3.5 and 3.7.14 (and/or viceversa)

Closed 2023-03-19.

Thread 26 (2023-04-12):

Target rate can get out of control all by itself, crashing RC

mirh, 2023-04-12:
So.. while I was investigating #10, after yet another lackluster run I just so happened to turn off all the sections in AOG (I'm listing from the top of my head everything that I can remember of the preceding seconds, but I don't really know if it they are useful/related).
I went back to the arduino IDE (or whatever other window that it was, not like it matters with RC always being on top) when I noticed that the target rate was quickly rising.

From around ~500-ish that I had set it, after 20-30 seconds it had skyrocketed to 40000, and counting.
And then RC crashed with this error.
```
************** Exception Text **************
System.ArgumentException: Must be between 0 and 50,000
   at RateController.clsProduct.set_RateSet(Double value)
   at RateController.clsSectionControl.ReadRateSwitches()
   at RateController.FormStart.timerMain_Tick(Object sender, EventArgs e)
   at System.Windows.Forms.Timer.OnTick(EventArgs e)
   at System.Windows.Forms.Timer.TimerNativeWindow.WndProc(Message& m)
   at System.Windows.Forms.NativeWindow.Callback(IntPtr hWnd, Int32 msg, IntPtr wparam, IntPtr lparam)
```
I don't know what settings/buttons/functions could increase the base rate unprompted, but one of them must be bugged (I was using the inos and [binaries](https://github.com/SK21/AOG_RC/tree/FixCal2/RateControllerApp) from your *FixCal2* branch FWIW).

SK21, 2023-04-13:
Were you using the on-screen rate increase switch or were you using a physical switchbox?

mirh, 2023-04-13:
No physical switchbox.
I believe I did have previously played with the on-screen buttons then, but not at any near point in time to the aforementioned events (AFAIR the corresponding window wasn't even open).

SK21, 2023-04-13:
I have adjusted the code to handle the error without crashing. I am not sure how it could have increased by itself. Does the switchbox use a momentary switch for rate?

mirh, 2023-04-13:
I don't have anything outside of the arduino, the sections/valve relays and the flowmeter.
I was running *RCnano* with a slightly modded `Motor.ino`, but that doesn't sound like it could influence rate...

Maybe yet [another](22) hijinx of intermingling an anciently created `Default.rcs` with the new versions? :\\
Anyway, putting aside that maybe the crashing wasn't all that bad considering the alternative was the undefined behaviour of infinite growth, I'll just close this because I don't have any other idea and after 2 years (lol) I'm very much wishing to have finally reached perfection with my setup.

mirh, 2023-05-20:
The target rate ballooning happens when you rapidly start and stop the calibration process while also playing with the rate up and down buttons.

Thread 28 (2023-04-16):

D18 and D19 turns on with every initialization

mirh, 2023-04-16:
I'm pretty much in a honeymoon phase now that everything works like in my smoothest dreams, but I have this quirk every time I power on my Nano (or I connect it to the pc, or to RC).

I could be expecting the master valve alone to create this problem, or somehow all the section relays to trigger together because whatever code reason I wasn't educated enough to figure out... Yet, instead, only section number 5 (wired and set to D18) has this kneejerk reaction. Like, I'm doubly dumbfounded this way. What could it have of special?
(this isn't *really* much of a problem then.. but still, it's kinda ruining perfection)

mirh, 2023-05-16:
Ok well... It seems like this is some kind of bootloader voodoo, no possible fault of yours (though it's crazy that it also somewhat happens even on the nano every that should use something completely different from optiboot)

    avrdude -c arduino  -p atmega328p -b 115200 -P port -t

Whenever you enter programming mode (or you reset the board thereof I guess?), you get the issue on D18/A4.
Worse even, I found that D19/A5 is *constantly* pulled high for the entire duration of the ordeal, not just for the blink of an eye.
Thankfully I do have quite the number of other pins that I can employ...

mirh, 2023-05-17:
Actually nevermind, my understanding of the bootloader modes was seemingly limited.
Whatever happens when you use the command above, if I upload an empty sketch it stops.
So.. I do guess it's something with the code here? Even though I cannot seem to find them anywhere...

mirh, 2023-08-12:
Ok, so, I did some bisecting.
This was introduced between 2.2.0-beta and 2.2.0-c, where even (at least) D4 was pulled up for some reason.
From 2.2.0-d instead (and ever since, including the last git) only the usual D18 and D19 seems to be on instead.

SK21, 2023-08-13:
I don't know what is causing this behaviour. A work around would be to use a MCP23017 (RC12_PCB) or PCA9555 (RelayDriver5 in modules) to control the relays.

mirh, 2023-08-13:
I mean, my workaround was eventually just to move around the wires and set up with the same relay D6.

Then, idk about that D4 oddity but D18/A4 and D19/A5 also happen to be the SDA and SCL pins. Does this ring a bell?
I reckon this could only have been either 6ab3da64519371f326c5a698758ea8aa0e7e9589 (pulling in some nasty new header?) or a905b8e1699570078a962c9ac47ed35eb792e4f3 reinventing too much of the wheel. Admittedly, my own job should have been already yesterday to assess this last question but after 2 hours I was tired.

mirh, 2023-08-16:
BEHOLD THE LINE (which somehow even works without the supposedly required header)
https://github.com/SK21/AOG_RC/blob/6578952a5a167dcfa5c80adb3c9b369a197101ed/Modules/Nano/RCnano/RCnano.ino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

Closed 2024-02-19.

Thread 30 (2023-04-29):

Nano Every has different motor relay control

mirh, 2023-04-29:
Ok, so.. For yet one further time, I'll have to reframe this issue (not because I have _completely_ crossed off my previous doubts, but because I realized there is an elephant in the room that clouded every other interpretation).

You'll certainly remember my broke ass [relay-controlled](https://github.com/SK21/AOG_RC/issues/10) valve.
I have really nothing meaningful to report about it running on the OG Nano, other than satisfaction.

***Yet*** for some ungodly reason, the same exact code flashed on the Nano Every has those controls go stupid.
The one that should increase flow, literally only turns on if the current rate is 0. The moment even a drop of water ticks the flowmeter it gives up even if you set a ludicrously high target.
While the one that should act to decrease the flow does work to an extent, even though it seems to have a quite bigger deadband.

My previously suspected culprit of everything bad was the EEPROM, but even version 2.1.12 still exhibits more or less the same behaviour.

Closed 2025-02-03.

Thread 31 (2023-05-04):

Doubts about RC manual mode

mirh, 2023-05-04:
The switches panel isn't covered/explained a lot by help files, so I had a couple of related conundrums:

- [ ] is it normal that when you press the *SectionMasterManual* button in AOG to stop spraying, RC tries to only ever act on the master relay (when *btAuto* is selected here instead, each section is also individually turned off)?
- [ ] following on that (and my [adventures](https://github.com/SK21/AOG_RC/pull/30) that were kinda forcing me onto using this) is it normal that even the bloody flow control pins are left switched on? I get that #10 is odd, but how and why can `digitalWrite(pin, 0)` not work?

I wasn't using the very latest RC (a month old or so if any) now that I think to it btw, but I didn't enable large screen mode so I hope missing your last commits didn't matter.

Closed 2024-02-19.

Thread 33 (2023-07-24):

Add minimum and maximum limits of flow per nozzle

mirh, 2023-07-24:
FWIW this is just a super finicky QOL feature, don't feel pressed into it and please prioritize far more important issues.

So long story short, as you are coming to a halt at the end of a line, your speed will lower. And so, with it, rate.
Of course there's no way for RC to know your motives for slowing down, and not like that's even much of a distinction worth making anyway (as long as you are within a field, you want to have coverage for every single meter).

***Yet*** below a certain pressure threshold, my nozzles don't have enough force to vaporize the water anymore and they just "pee".
This also further carries over on the next row (when you are then re-starting from a standstill) where the first meters will just drip a trickle of water rather than the full ass spray.

The "minimum cutoff speed" setting that AOG has in the *attachment sections* menu does kinda help I guess, but this use case isn't exactly its purpose and it could not account for the difference between having 2 or 10 sections running.
So for this reason, I was envisioning a "minimum nozzle rate" option (measured in litres per second) that could clamp whatever the current rate per hectare is. Because sometimes using a bit too much liquid is better than "practically none".

p.s. I don't personally see a scenario for the maximum limit, but nonetheless I thought it should be a cakewalk to implement once the logic for its mirror-opposite was already in place

SK21, 2023-07-25:
There is a minimum UPM setting in product options. It is not based on working width or number of sections on. It could be changed to this.

mirh, 2023-07-26:
I reckon you are right, though I don't think width should have any relevance here.

Closed 2024-02-19.

Thread 35 (2025-01-27):

The application stops when I want to load a shapemap.

SLOWiK83, 2025-01-27:
The application stops when I want to load a shapemap. This only happens when I start AOG.

SK21, 2025-01-27:
When AOG is running RC stops or freezes? Is there any information in the error report on the help page?

SLOWiK83, 2025-01-27:
This is the error that forces the application to stop, I mean to turn it off. Unfortunately, my windows is in Polish.

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

Here is the text of the error:

Szczegółowe informacje na temat wywoływania debugowania w trybie JIT (just in time)
zamiast tego okna dialogowego znajdują się na końcu tego komunikatu.

************** Tekst wyjątku **************
System.IO.FileNotFoundException: Nie można załadować pliku lub zestawu 'ProjNET, Version=2.0.0.0, Culture=neutral, PublicKeyToken=a1f5bdcd9c6f5740' lub jednej z jego zależności. Nie można odnaleźć określonego pliku.
Nazwa pliku: 'ProjNET, Version=2.0.0.0, Culture=neutral, PublicKeyToken=a1f5bdcd9c6f5740'
   w RateController.Classes.MapZone.CalculateArea(Polygon polygon)
   w RateController.Classes.MapZone.Hectares() w G:\Sync\Documents\GitHub\SK21\AOG_RC\RateAppSource\RateController\Classes\MapZone.cs:wiersz 39
   w RateController.Classes.MapManager.UpdateRates() w G:\Sync\Documents\GitHub\SK21\AOG_RC\RateAppSource\RateController\Classes\MapManager.cs:wiersz 257
   w RateController.Menu.frmMenuRateMap.UpdateForm() w G:\Sync\Documents\GitHub\SK21\AOG_RC\RateAppSource\RateController\Menu\frmMenuRateMap.cs:wiersz 441
   w RateController.Menu.frmMenuRateMap.Manager_MapChanged(Object sender, EventArgs e) w G:\Sync\Documents\GitHub\SK21\AOG_RC\RateAppSource\RateController\Menu\frmMenuRateMap.cs:wiersz 276
   w RateController.Classes.MapManager.LoadMap(String path) w G:\Sync\Documents\GitHub\SK21\AOG_RC\RateAppSource\RateController\Classes\MapManager.cs:wiersz 169
   w RateController.Menu.frmMenuRateMap.btnLoad_Click(Object sender, EventArgs e) w G:\Sync\Documents\GitHub\SK21\AOG_RC\RateAppSource\RateController\Menu\frmMenuRateMap.cs:wiersz 80
   w System.Windows.Forms.Control.OnClick(EventArgs e)
   w System.Windows.Forms.Button.OnClick(EventArgs e)
   w System.Windows.Forms.Button.OnMouseUp(MouseEventArgs mevent)
   w System.Windows.Forms.Control.WmMouseUp(Message& m, MouseButtons button, Int32 clicks)
   w System.Windows.Forms.Control.WndProc(Message& m)
   w System.Windows.Forms.ButtonBase.WndProc(Message& m)
   w System.Windows.Forms.Button.WndProc(Message& m)
   w System.Windows.Forms.Control.ControlNativeWindow.OnMessage(Message& m)
   w System.Windows.Forms.Control.ControlNativeWindow.WndProc(Message& m)
   w System.Windows.Forms.NativeWindow.Callback(IntPtr hWnd, Int32 msg, IntPtr wparam, IntPtr lparam)

OSTRZEŻENIE: rejestrowanie informacji o powiązaniach zestawów jest wyłączone.
Aby włączyć rejestrowanie błędów powiązań zestawów, ustaw wartość rejestru [HKLM\Software\Microsoft\Fusion!EnableLog] (DWORD) równą 1.
Uwaga: z włączeniem rejestrowania błędów powiązań zestawów wiąże się pewien spadek wydajności.
Aby wyłączyć tę funkcję, usuń wartość rejestru [HKLM\Software\Microsoft\Fusion!EnableLog].

************** Zestawy załadowane **************
mscorlib
    Wersja zestawu: 4.0.0.0
    Wersja Win32: 4.8.9290.0 built by: NET481REL1LAST_C
    CodeBase: file:///C:/Windows/Microsoft.NET/Framework/v4.0.30319/mscorlib.dll
----------------------------------------
RateController
    Wersja zestawu: 1.0.0.0
    Wersja Win32: 1.0.0.0
    CodeBase: file:///C:/Users/user/Desktop/RateControllerApp%204.0.0%20B5/RateController.exe
----------------------------------------
System
    Wersja zestawu: 4.0.0.0
    Wersja Win32: 4.8.9282.0 built by: NET481REL1LAST_C
    CodeBase: file:///C:/Windows/Microsoft.Net/assembly/GAC_MSIL/System/v4.0_4.0.0.0__b77a5c561934e089/System.dll
----------------------------------------
System.Windows.Forms
    Wersja zestawu: 4.0.0.0
    Wersja Win32: 4.8.9251.0 built by: NET481REL1LAST_C
    CodeBase: file:///C:/Windows/Microsoft.Net/assembly/GAC_MSIL/System.Windows.Forms/v4.0_4.0.0.0__b77a5c561934e089/System.Windows.Forms.dll
----------------------------------------
System.Drawing
    Wersja zestawu: 4.0.0.0
    Wersja Win32: 4.8.9037.0 built by: NET481REL1
    CodeBase: file:///C:/Windows/Microsoft.Net/assembly/GAC_MSIL/System.Drawing/v4.0_4.0.0.0__b03f5f7f11d50a3a/System.Drawing.dll
----------------------------------------
System.Configuration
    Wersja zestawu: 4.0.0.0
    Wersja Win32: 4.8.9037.0 built by: NET481REL1
    CodeBase: file:///C:/Windows/Microsoft.Net/assembly/GAC_MSIL/System.Configuration/v4.0_4.0.0.0__b03f5f7f11d50a3a/System.Configuration.dll
----------------------------------------
System.Core
    Wersja zestawu: 4.0.0.0
    Wersja Win32: 4.8.9277.0 built by: NET481REL1LAST_B
    CodeBase: file:///C:/Windows/Microsoft.Net/assembly/GAC_MSIL/System.Core/v4.0_4.0.0.0__b77a5c561934e089/System.Core.dll
----------------------------------------
System.Xml
    Wersja zestawu: 4.0.0.0
    Wersja Win32: 4.8.9037.0 built by: NET481REL1
    CodeBase: file:///C:/Windows/Microsoft.Net/assembly/GAC_MSIL/System.Xml/v4.0_4.0.0.0__b77a5c561934e089/System.Xml.dll
----------------------------------------
RateController.resources
    Wersja zestawu: 1.0.0.0
    Wersja Win32: 1.0.0.0
    CodeBase: file:///C:/Users/user/Desktop/RateControllerApp%204.0.0%20B5/pl/RateController.resources.DLL
----------------------------------------
GMap.NET.Core
    Wersja zestawu: 2.1.7.0
    Wersja Win32: 2.1.7.0
    CodeBase: file:///C:/Users/user/Desktop/RateControllerApp%204.0.0%20B5/GMap.NET.Core.DLL
----------------------------------------
GMap.NET.WindowsForms
    Wersja zestawu: 2.1.7.0
    Wersja Win32: 2.1.7.0
    CodeBase: file:///C:/Users/user/Desktop/RateControllerApp%204.0.0%20B5/GMap.NET.WindowsForms.DLL
----------------------------------------
System.Data.SQLite
    Wersja zestawu: 1.0.119.0
    Wersja Win32: 1.0.119.0
    CodeBase: file:///C:/Users/user/Desktop/RateControllerApp%204.0.0%20B5/System.Data.SQLite.DLL
----------------------------------------
System.Data
    Wersja zestawu: 4.0.0.0
    Wersja Win32: 4.8.9214.0 built by: NET481REL1LAST_B
    CodeBase: file:///C:/Windows/Microsoft.Net/assembly/GAC_32/System.Data/v4.0_4.0.0.0__b77a5c561934e089/System.Data.dll
----------------------------------------
System.Transactions
    Wersja zestawu: 4.0.0.0
    Wersja Win32: 4.8.9037.0 built by: NET481REL1
    CodeBase: file:///C:/Windows/Microsoft.Net/assembly/GAC_32/System.Transactions/v4.0_4.0.0.0__b77a5c561934e089/System.Transactions.dll
----------------------------------------
System.EnterpriseServices
    Wersja zestawu: 4.0.0.0
    Wersja Win32: 4.8.9037.0 built by: NET481REL1
    CodeBase: file:///C:/Windows/Microsoft.Net/assembly/GAC_32/System.EnterpriseServices/v4.0_4.0.0.0__b03f5f7f11d50a3a/System.EnterpriseServices.dll
----------------------------------------
NetTopologySuite.IO.Esri.Shapefile
    Wersja zestawu: 1.0.0.0
    Wersja Win32: 1.0.0.0
    CodeBase: file:///C:/Users/user/Desktop/RateControllerApp%204.0.0%20B5/NetTopologySuite.IO.Esri.Shapefile.DLL
----------------------------------------
netstandard
    Wersja zestawu: 2.0.0.0
    Wersja Win32: 4.8.9037.0
    CodeBase: file:///C:/Windows/Microsoft.Net/assembly/GAC_MSIL/netstandard/v4.0_2.0.0.0__cc7b13ffcd2ddd51/netstandard.dll
----------------------------------------
NetTopologySuite.Features
    Wersja zestawu: 2.0.0.0
    Wersja Win32: 2.0.0.0
    CodeBase: file:///C:/Users/user/Desktop/RateControllerApp%204.0.0%20B5/NetTopologySuite.Features.DLL
----------------------------------------
NetTopologySuite
    Wersja zestawu: 2.0.0.0
    Wersja Win32: 2.0.0.0
    CodeBase: file:///C:/Users/user/Desktop/RateControllerApp%204.0.0%20B5/NetTopologySuite.DLL
----------------------------------------
System.Buffers
    Wersja zestawu: 4.0.4.0
    Wersja Win32: 4.600.24.56208
    CodeBase: file:///C:/Users/user/Desktop/RateControllerApp%204.0.0%20B5/System.Buffers.DLL
----------------------------------------
System.Memory
    Wersja zestawu: 4.0.2.0
    Wersja Win32: 4.600.24.56208
    CodeBase: file:///C:/Users/user/Desktop/RateControllerApp%204.0.0%20B5/System.Memory.DLL
----------------------------------------
System.Runtime.CompilerServices.Unsafe
    Wersja zestawu: 6.0.1.0
    Wersja Win32: 6.100.24.56208
    CodeBase: file:///C:/Users/user/Desktop/RateControllerApp%204.0.0%20B5/System.Runtime.CompilerServices.Unsafe.DLL
----------------------------------------
System.ValueTuple
    Wersja zestawu: 4.0.0.0
    Wersja Win32: 4.8.9037.0
    CodeBase: file:///C:/Windows/Microsoft.Net/assembly/GAC_MSIL/System.ValueTuple/v4.0_4.0.0.0__cc7b13ffcd2ddd51/System.ValueTuple.dll
----------------------------------------
System.Windows.Forms.resources
    Wersja zestawu: 4.0.0.0
    Wersja Win32: 4.8.9037.0 built by: NET481REL1
    CodeBase: file:///C:/Windows/Microsoft.Net/assembly/GAC_MSIL/System.Windows.Forms.resources/v4.0_4.0.0.0_pl_b77a5c561934e089/System.Windows.Forms.resources.dll
----------------------------------------
mscorlib.resources
    Wersja zestawu: 4.0.0.0
    Wersja Win32: 4.8.9037.0 built by: NET481REL1
    CodeBase: file:///C:/Windows/Microsoft.Net/assembly/GAC_MSIL/mscorlib.resources/v4.0_4.0.0.0_pl_b77a5c561934e089/mscorlib.resources.dll
----------------------------------------

************** Debugowanie w trybie JIT **************
Aby włączyć debugowanie w trybie just in time (JIT), plik .config tej
aplikacji lub komputera (machine.config) musi mieć
wartość jitDebugging ustawioną w sekcji system.windows.forms.
Aplikacja musi być również skompilowana z włączonym
debugowaniem.

Na przykład:

<configuration>
    <system.windows.forms jitDebugging="true" />
</configuration>

Gdy debugowanie JIT jest włączone, wszystkie nieobsługiwane wyjątki
są wysyłane do debugera JIT zarejestrowanego na komputerze
i nie są obsługiwane w tym oknie dialogowym.

SK21, 2025-01-27:
What version of RC are you using? Does ProjNet.dll show up in the app folder?

SLOWiK83, 2025-01-27:
4.0.0. beta 5 from 3 days ago.

I have corrected my previous post, it is now from a computer with English language.

I have performed tests on another machine, because the first tests of AOG v6.6.2 and RC on the first computer, caused that after uploading the maps, I enjoyed the working application for a moment and driving around the field and the variable value... I can't name it, here is a photo

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

SK21, 2025-01-27:
That shows the size of the zone in hectares or acres.

mirh, 2025-01-28:
Do older versions work?

SLOWiK83, 2025-01-28:
Yes, the functionality of uploading map files worked fine in the previous RC version. Maybe I had an error once, but not with the "arrow up" button in the "MAP" section, but with the "import" button, I had such an exception in Windows.

SK21, 2025-01-28:
The last version added the area counter with ProjNet.dll. Did you find it in the app folder? Is this still not working?

SLOWiK83, 2025-01-28:
Here is my file list, in the latest RC version, there is no the file you are asking about.

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

SK21, 2025-01-28:
I just checked the release and ProjNet.dll is included. I don't know why it isn't in your app folder. Could Windows Defender be blocking the file?

mirh, 2025-01-29:
It'd be probably quicker if you could tell what was the first version that was broken.

SLOWiK83, 2025-01-29:
Very strange situation with this application. Initially I tested 4.0.0-beta.4, which was unfinished and generally did not work properly.

As soon as version 4.0.0-beta.5 came out I launched it and initially everything worked and I was happy that the problems were solved. However, at some point it stopped launching, which I described at the beginning of this thread (Issue).

Indeed! I was missing the file that SK21 talks about. I immediately downloaded RC again, but this time the application did not launch at all :/

today I looked at GitHub\AOG_RC\RateControllerApp and here's a surprise, the set of files to download is different, much smaller.

Are you sure everything is OK with the file repository on GitHub?

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

SK21, 2025-01-29:
The first list of files is from the Master branch. It has less files. The Development branch has more files but it was missing a couple of folders. These were blocked by gitignore. This has been fixed. If you had downloaded the source files this was a problem. The zipped app folder in the release would have still worked as the missing files were included there. Now both the source zip and the zipped app folder contain the missing files in the new release 6.

SLOWiK83, 2025-01-30:
This time(beta6) the Error is as follows, I attach a photo, and the contents of the error in the text file. It appears after uploading the Application Map file, while I click on the areas on the map, indicated by the yellow arrow.

1. I am beginning to wonder if the Application Map file is correct, as there is one distinctive vertical line in the left part of the zones indicated by the red curves. Do you also see it?  I can even say that the yellow arrow points directly at it.

I am also attaching a file of my maps.

I would appreciate your help and thank you for your prompt response to the problem so far.

Translated with DeepL.com (free version)

[Application Map - Shape.zip](https://github.com/user-attachments/files/18602080/Application.Map.-.Shape.zip)

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

[error1.txt](https://github.com/user-attachments/files/18602087/error1.txt)

2. The question is how to upload the map ? With which button ? Are the two the same ? In the picture 'button to import' I showed two buttons described A and B, to find out which is better for importing.

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

SK21, 2025-01-30:
That one zone is not formed properly. The vertical line on the right side does not complete the zone. I have added error handling to prevent the crash.

To convert a shape file to match the attributes of a RC shape file use 'Import'. This allows you to cross reference attributes from the file to be imported to a new shape file that has the attributes that RC recognizes.

To load a RC shape file use the button with the up arrow. To save a RC shape file use the button with the down arrow.

There is help available for the page using the '?' button. It provides a pdf file for the page. It is in English but it should be able to be translated on-line.

[test.zip](https://github.com/user-attachments/files/18603039/test.zip)
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

SLOWiK83, 2025-01-31:
Thank you for your help so far. I have now uploaded the map without those vertical lines and it works fine. The topic of where these lines come from is still to be solved. The portal from which I export these maps shows me on other applications for reading such maps that there are no vertical lines there. I'm afraid that I'm generating them during the import into RCapp.

As a next step, I need information on how to get RC to show the VR Target value, and other values, mileage, area?

At the moment when I run AOG, the marker moves around the map in RCapp , but no values in RCapp change. Although, when I approach the map file value, the dose values are in the file assigned to each zone.

SLOWiK83, 2025-01-31:
I do the same as in the video and unfortunately only the acreage(area) changes in my case. Instead of the zone name it is Unnamed Zone, and with Product 1 it is zero all the time and nothing happens.

Do you guys have some other version ? Is it a good idea to delete the directories from C:\nDocuments and C:\nAppData.nameLocalRateController before this operation ?

In your video you can't see how you use the up arrow button, and without it there will be no curves with zone division on the map.

I really want to get this functionality working, but I guess I'm out of luck :-(

Can You tell me, what app do you use for recording desktop ?

SK21, 2025-01-31:
I am using the same version as the latest update. It is not necessary to delete directories but it shouldn't hurt to do so. The up arrow on the import form just loads the file to be imported. Once the file is saved with the new name it needs to be opened on the main form. Did you try the test.zip file further up in the discussion? If the zone name does not change or the Product A rate it would seem that these attributes were not cross-referenced correctly.

For screen recording I use this:  https://github.com/obsproject/obs-studio
Set the output format to mpeg-4 for smaller files.

SLOWiK83, 2025-02-03:
I already know everything, only thanks to your last post, I understood the essence of the matter. That first IMPORT (cross-referenced), then uploading what I saved using the IMPORT method. And uploading using the arrow button (LOAD).

Now everything works for me, thank you very much for your help and patience. It is worth including this in the help file, because it is not intuitive.

SK21, 2025-02-03:
Thanks for your feedback. Here is the revised file.

[frmMenuRateMap.pdf](https://github.com/user-attachments/files/18639374/frmMenuRateMap.pdf)

SLOWiK83, 2025-02-03:
Great, I'm glad I could contribute a little to your efforts. I have one more topic, but I'll open a new thread because this one is getting too long.

Thread 36 (2025-02-03):

Maps Generated after treatment

SLOWiK83, 2025-02-03:
I wanted to ask if RateControllerApp has the ability to export Post-Construction Maps? I don't know if the translator translates well.

The point is that application maps generated by FMS should generate another file in the tractor's on-board systems after the treatment, in which the actual/real parameters of the performed treatment will be saved, such as the dose and the area covered by this dose.

Is there something like that in your application, or will it be implemented?

SK21, 2025-02-03:
There is no feature like that in the app. It could possibly be implemented. Do you have an example file?

SLOWiK83, 2025-02-14:
I was able to access sample as-built maps from a specific agricultural equipment manufacturer.

https://github.com/JohnDeere/SampleData/tree/master/Shapefiles

Closed 2025-06-17.

Thread 37 (2025-02-03):

UART Communication

SLOWiK83, 2025-02-03:
Do I see correctly that in the latest RC version, there is no longer a module responsible for UART configuration? And that the only communication option is TCP/IP?

SK21, 2025-02-03:
Yes. The serial communication was very unreliable. Communication over serial with the switchbox would sometimes lock up the whole application.

SLOWiK83, 2025-02-03:
OK, so if I don't have a network built yet and there's nothing to receive my data, then tell me how I can monitor packets sent by RC? WireShark? But how are they generated? Is it BroadCast? Or what is the destination of such packets? Or does the connection from the module generate packet traffic?

SK21, 2025-02-03:
PGNs are sent out over udp. Here is some example code:  https://github.com/SK21/AOG_RC/tree/master/Modules/Teensy%20Rate/RCteensy

SLOWiK83, 2025-02-04:
Do you have knowledge of how such a data frame will look like what will be the source IP address, destination IP address, port ? Meaning the source address, will be the same as the IP of the computer on which RC is running, but I have trouble catching such a frame. Is some more advanced configuration needed for it to be sent during the AOG run, where the RC controls the dose ?

SK21, 2025-02-04:
Rate App comm with modules:
Receive Port 	29999
Send Port	28888
Send from Port	1480

The IP of the app is set on the modules network page. It is one of the subnets available on the PC. The subnet can be sent to the modules from there.

Rate App comm with AOG:
The App communicates with AOG over Windows loopback.
Receive Port	17777
Send Port	15555
Send from Port	1460

Modules comm with App:
Receive Port	28888
Send Port	29999
Send to IP	subnet + .255			ex 192.168.5.255
Send from IP	subnet + (.50 + module ID)	ex subnet 192.168.5, ID=1, 192.168.5.51

[Rate_PGNs.pdf](https://github.com/user-attachments/files/18657671/Rate_PGNs.pdf)

mirh, 2025-04-28:
I don't want to pretend to be an expert (I'm not even using a PCB, let alone resistors or whatnot) but this is quite puzzling.
First because at least with my meagre nano and 8 relays tops, I don't remember for at least these kinds of problems (and regardless of who is the cause, if a program on the computer side freezes then it seems hard to blame anything else).

But secondly because I feel like this could close doors? Like, assuming you wanted to implement some kind of bluetooth support, the first thing you'd try was serial over it.

Closed 2025-02-17.

Thread 38 (2025-02-06):

Diffference between Schematics and PCB Bom

buched, 2025-02-06:
in your RC15 schematics, its seem C5 C13 and C11 are polarized capacitor.
in Bom, C59461 ref seem non polarized capacitor.
wich ref good ?

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

SK21, 2025-02-06:
The BOM is good. It is an error in the schematic.

Closed 2025-02-17.

Thread 39 (2025-02-17):

Unexpected vertical lines on maps

SLOWiK83, 2025-02-17:
There is a problem, because loading maps from our system often generates vertical dashes, as in the following picture.

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

This is a zone generation bug that generates an error and crashes the application when a vehicle enters the zone affected by this vertical dash

When I generated the map from the cloud application for agriculture and opened it with another application to visualize the shapes generated on the fields(dosage zones), there was no vertical dash there. Based on this, I believe that it is the fault of your application.

SK21, 2025-02-17:
Could I get a copy of the file to test?

SLOWiK83, 2025-02-18:
[Dzialka_.42_2025-01-23_aaa.zip](https://github.com/user-attachments/files/18840488/Dzialka_.42_2025-01-23_aaa.zip)

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

SK21, 2025-02-27:
Try beta 8 to see if it works correctly now. The problem was the way gmap.net handles polygons with holes.

Thread 40 (2025-04-26):

No one fingered way to move the window

mirh, 2025-04-26:
Long story short, there's just no way to move the new 3.8.0+ interface with a touchscreen.

Besides, it's only by pure chance minutes before sending this issue that I figured how to do it with the mouse... I really don't think the right click drag is intuitive (even though I'll grant it's nice to shave off the few pixels of the title bar).

SK21, 2025-04-27:
Long press is equivalent to right-click on a touchscreen. Long press will move the window. I agree it is not intuitive. I am open to suggestions on a better way.

mirh, 2025-04-27:
Uh.. Ok actually that's surprisingly comfy and workable now that I tried it.
And I guess like it's not something that I'd want to remove.

Still I feel like there should be a plan B (I swear I was using 3.9.0 because at least sub-menus could be moved the normal way there).
How about creating a sort of faux title bar: the name of the current product on the left, the X and _ buttons on the right, and all the space in between works the good old dragging way?
(ofc the unit of measurement would have to go away or at least move.. but tbh that seems something that should happen anyway, considering it technically only applies to the first two rows while it's out of place for the quantity and the area when shown separately)

Closed 2025-06-17.

Thread 41 (2025-05-24):

AOG_RC/Modules/ESP32 Rate/RC_ESP32/RC_ESP32.ino does not compile in Arduino IDE 2.3.6

WildBuckwheat, 2025-05-24:
RC_ESP32.ino line 3 needs to have some lower case changed to upper case, from
#include <pcf8574.h>		// https://github.com/RobTillaart/PCF8574
to
#include <PCF8574.h>		// https://github.com/RobTillaart/PCF8574

The functions
void IRAM_ATTR ISR0()
and
void IRAM_ATTR ISR1()
need to be placed after the definition of
void IRAM_ATTR PulseISR(uint8_t ID)

Thread 42 (2025-05-28):

Auto rate control problem with large screen

andyi1980, 2025-05-28:
When the Large screen is selected the app will not start rate control with the Auto function.

With the small screen window it works as it should.

However the small screen window cannot be moved and it makes it impossible to use the Menu options for example changing Product or Machine settings, which the means you have to revert to the large screen.

SK21, 2025-05-28:
Just tested large screen. Auto and Master both work. If the switchbox is connected it will take precedence over the large screen buttons. The small screen can be moved by right-clicking or long press. On the development branch I also added moving by left-clicking in the top left area.

Closed 2025-06-17.
