SK21/AOG_RC/Help/RC schematic 3 wire encoder.pdf

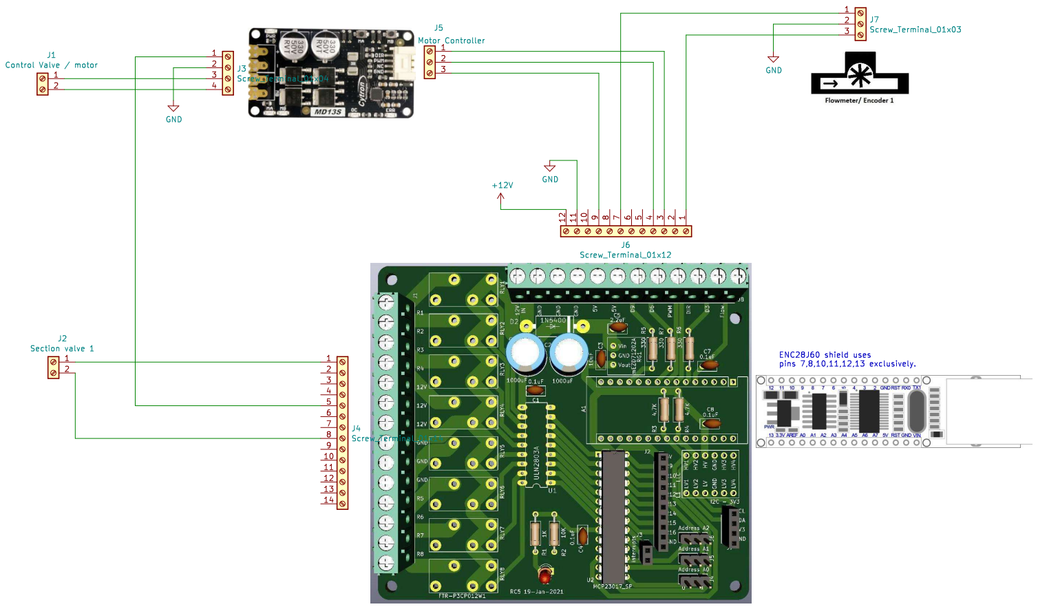
[picture p19: page 1]
