SK21/AOG_RC/Help/PCB Schematics/RC12-2 Schematic.pdf

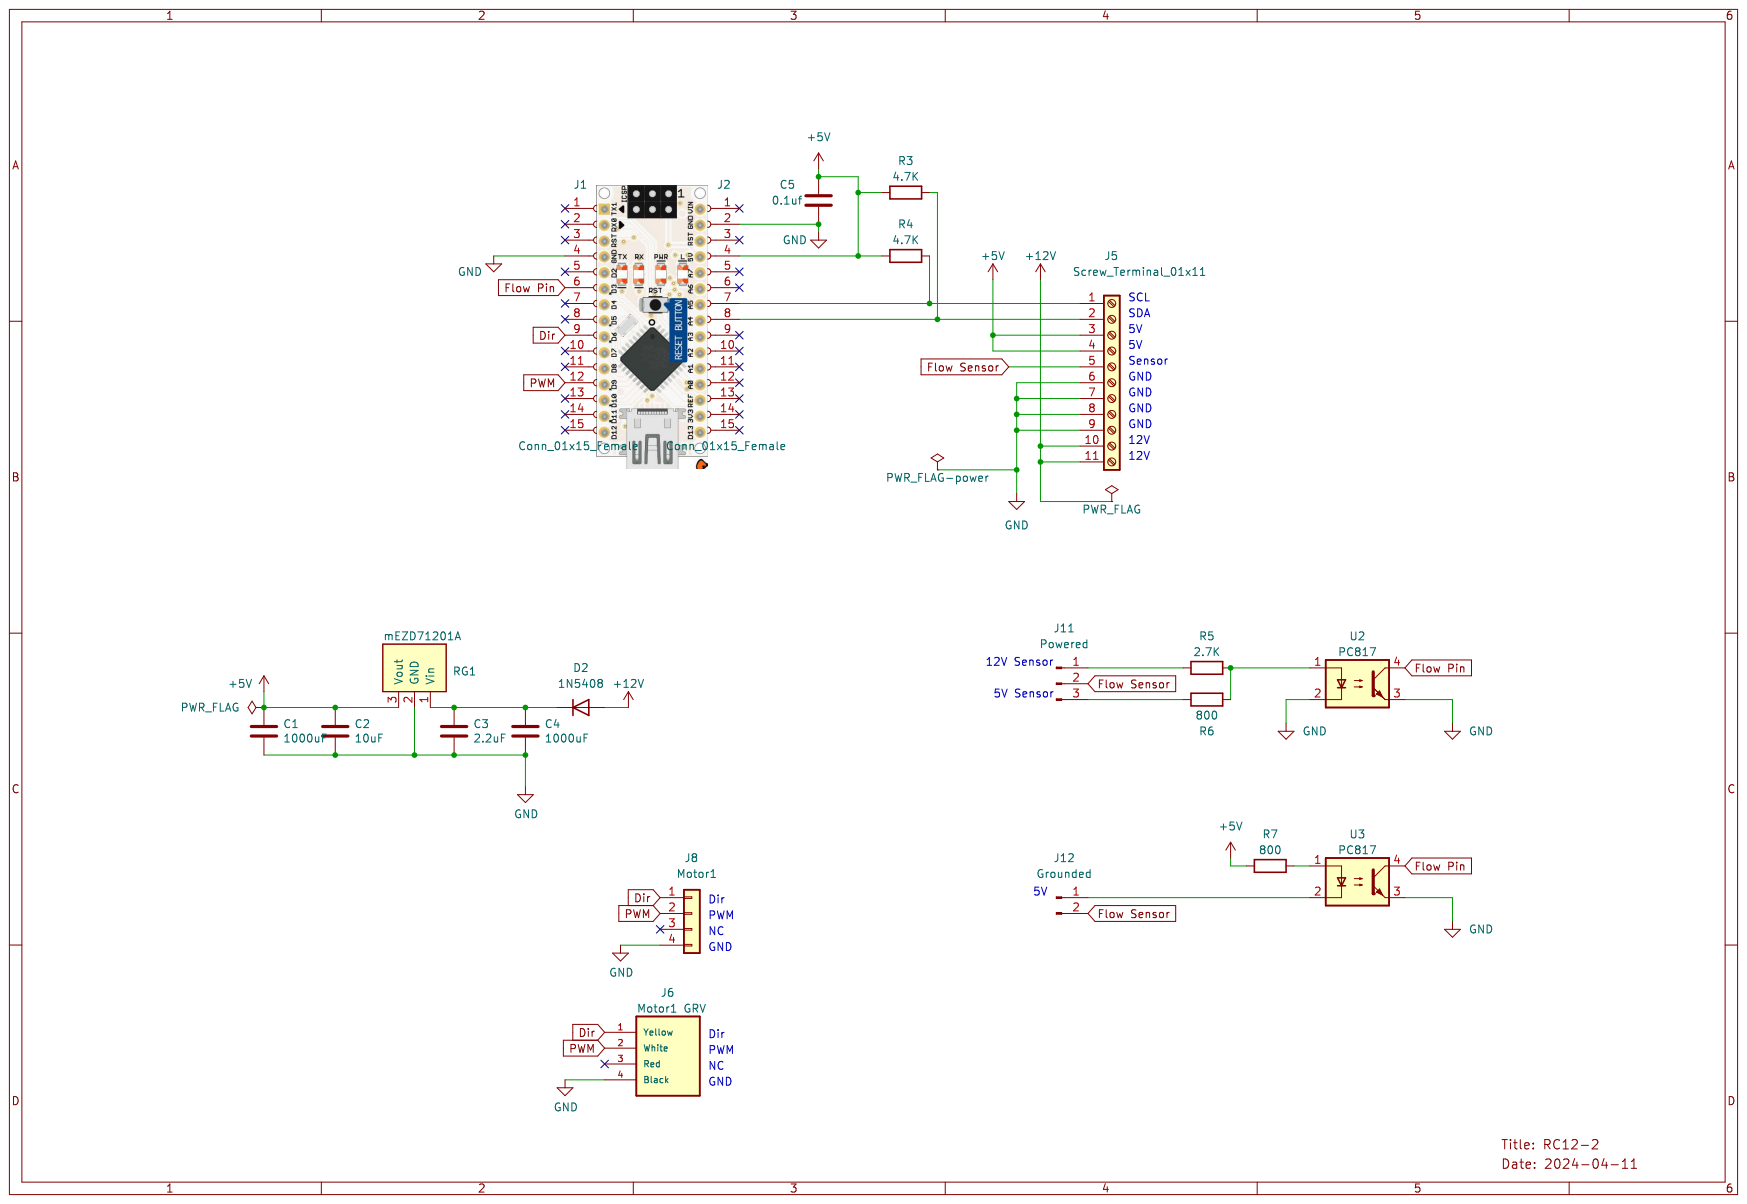
[picture p20: page 1]
