SK21/AOG_RC/Help/PCB Schematics/RC15 Schematic.pdf

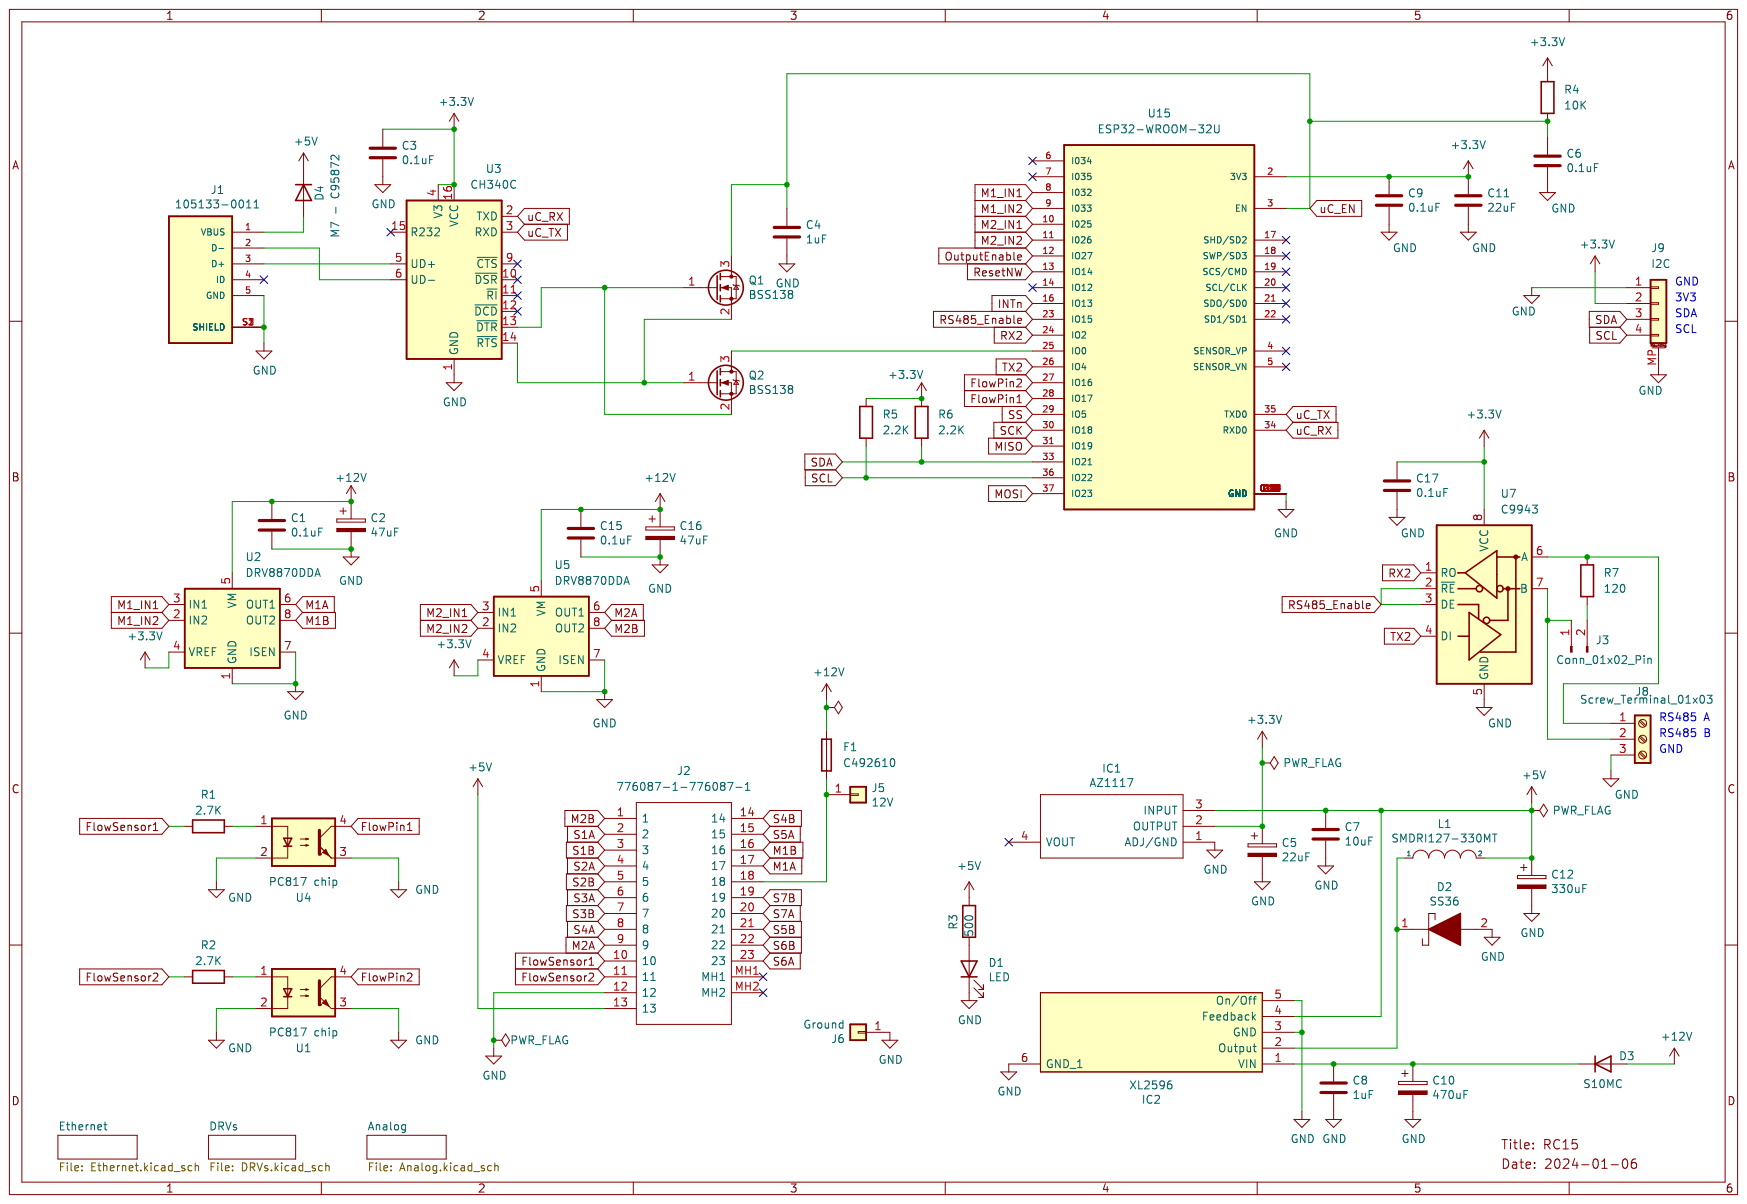
[picture p26: page 1]

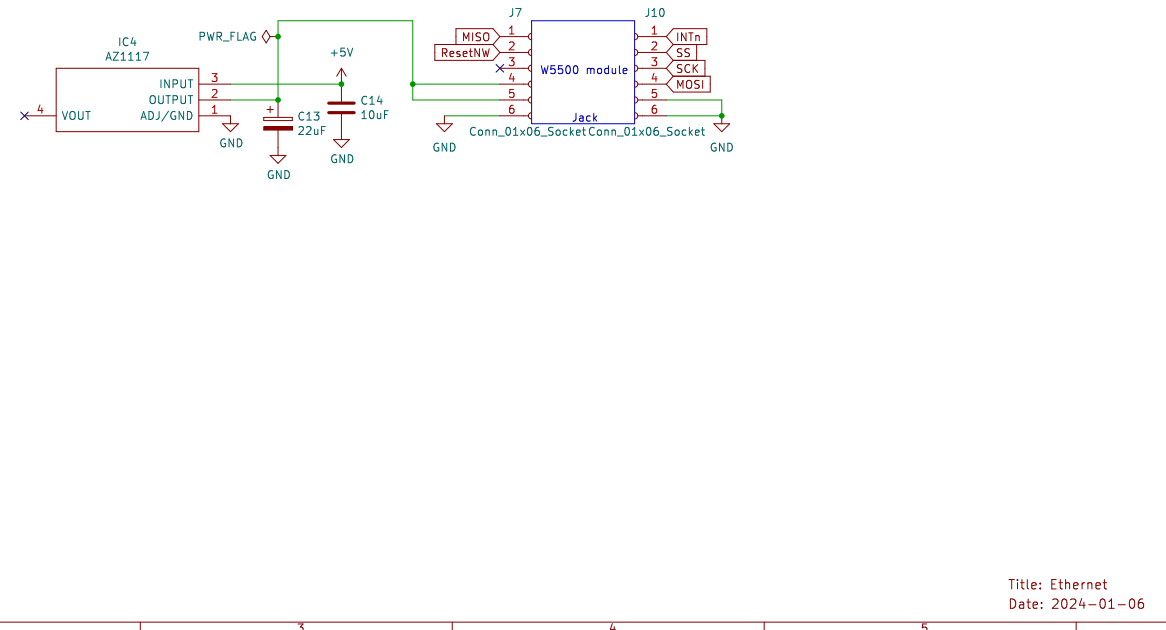
[picture p27: page 2]

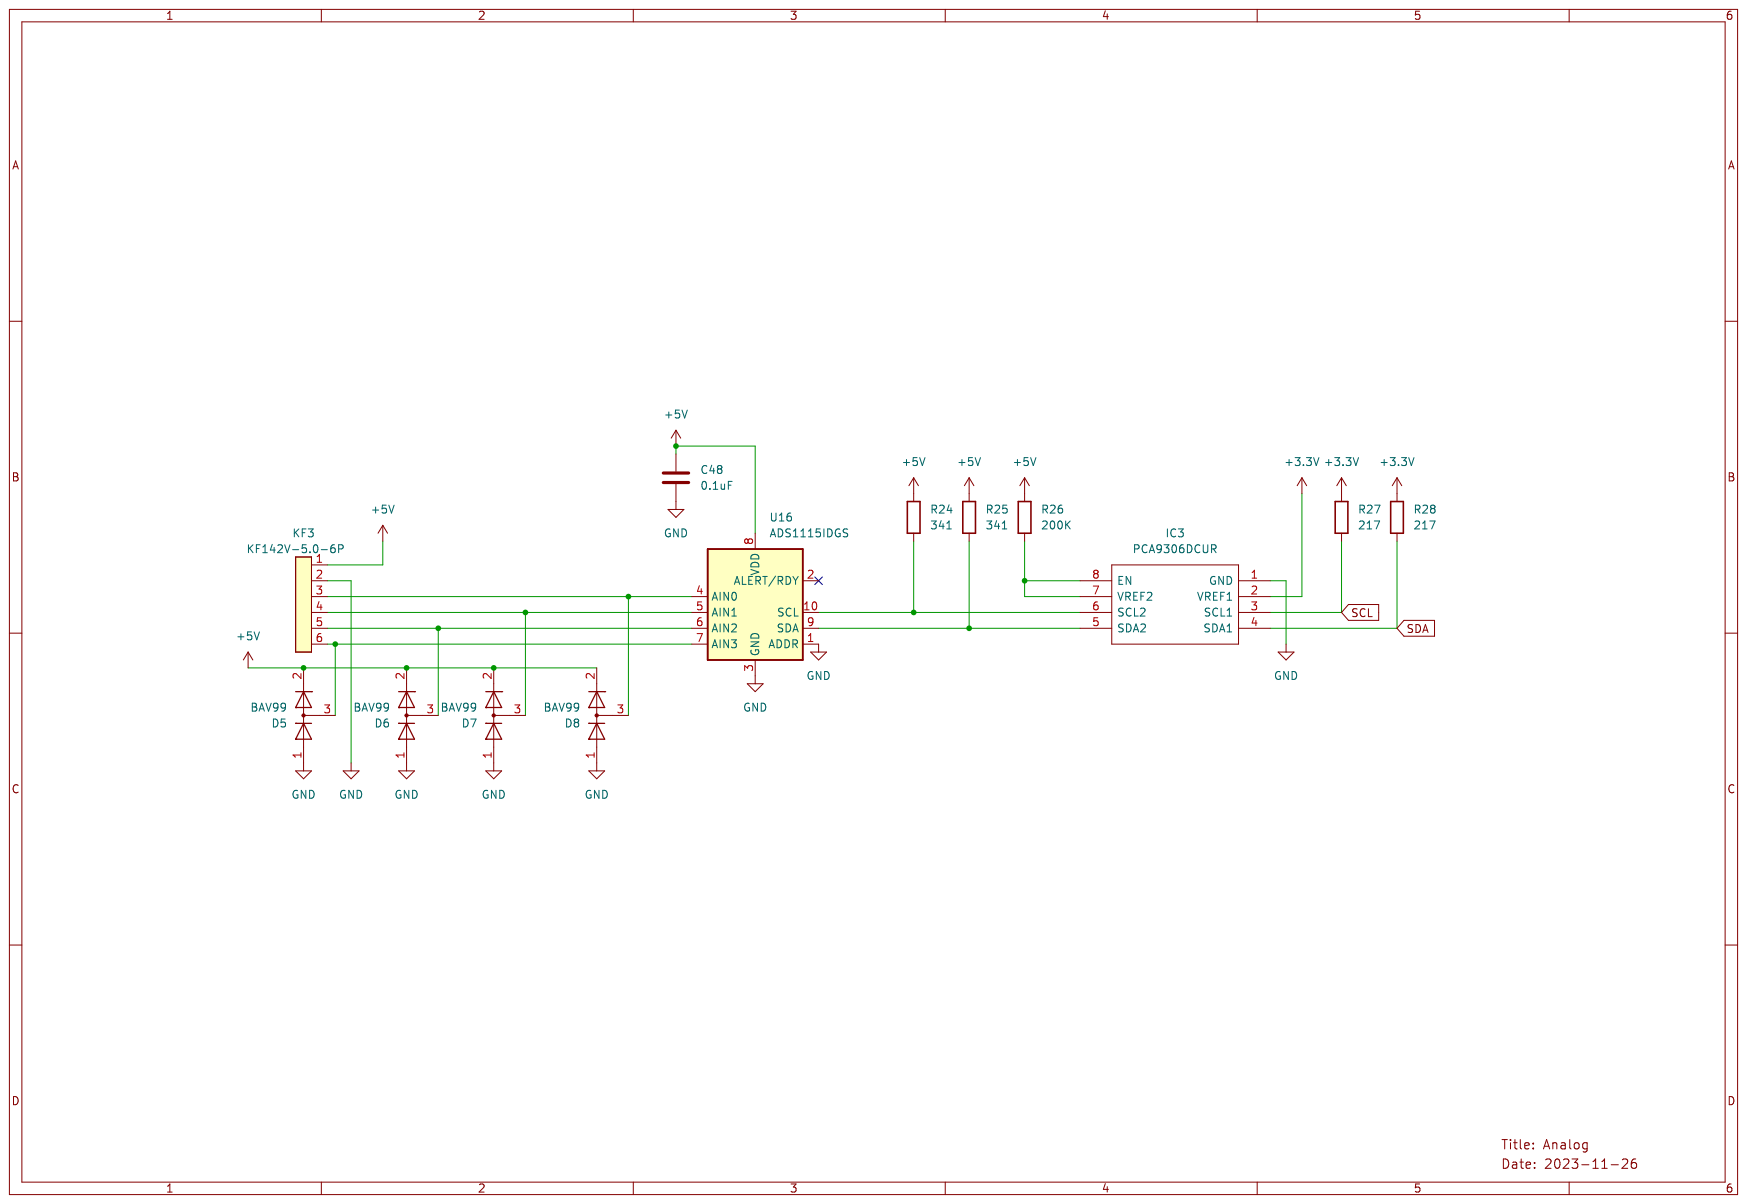
[picture p28: page 3]

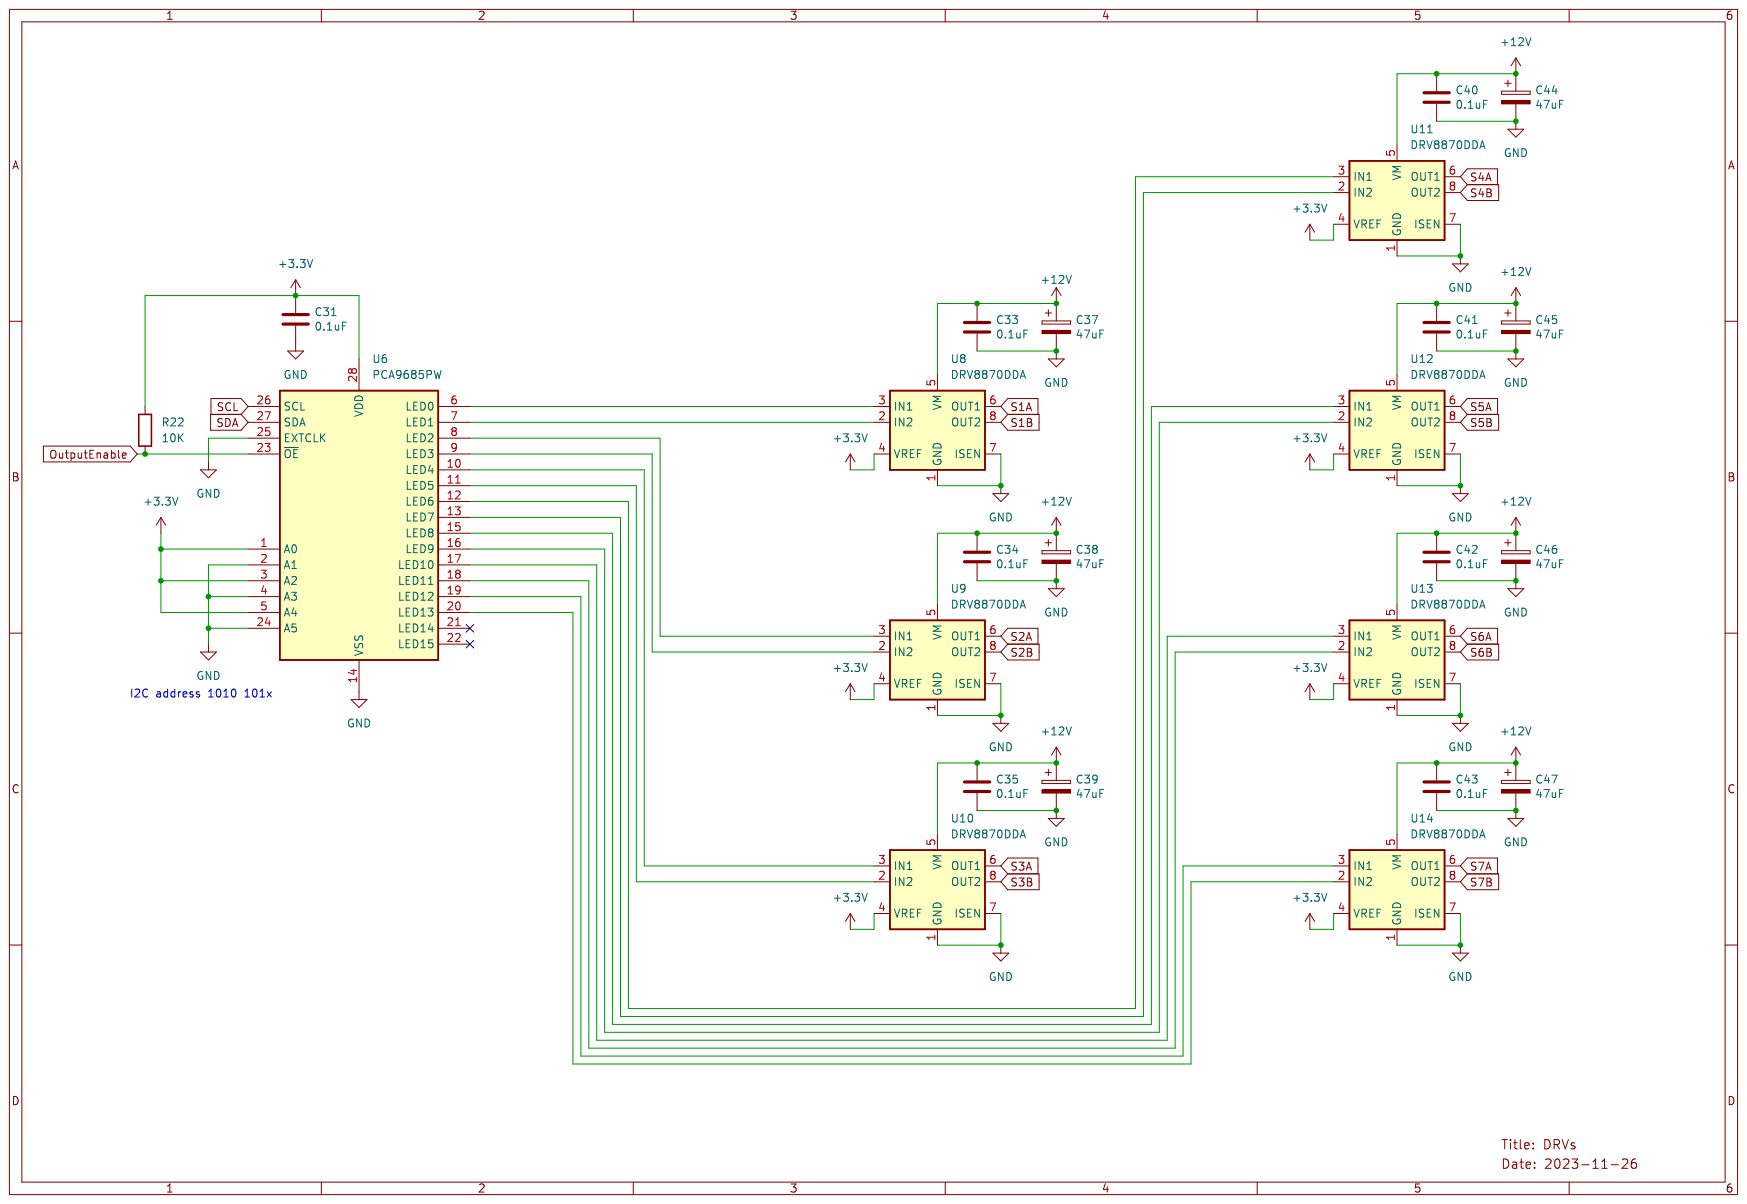
[picture p29: page 4]
