SK21/AOG_RC/Help/PCB Schematics/RelayDriver Schematic.pdf

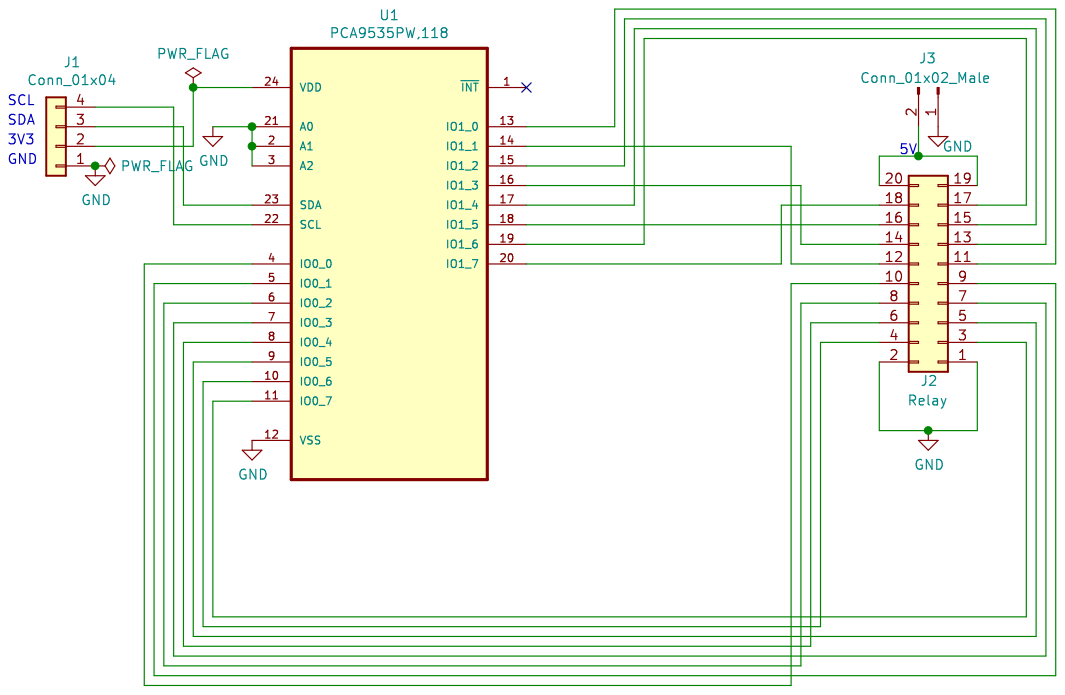
[picture p36: page 1]
