SK21/AOG_RC/Help/PCB Schematics/SW2 Schematic.pdf

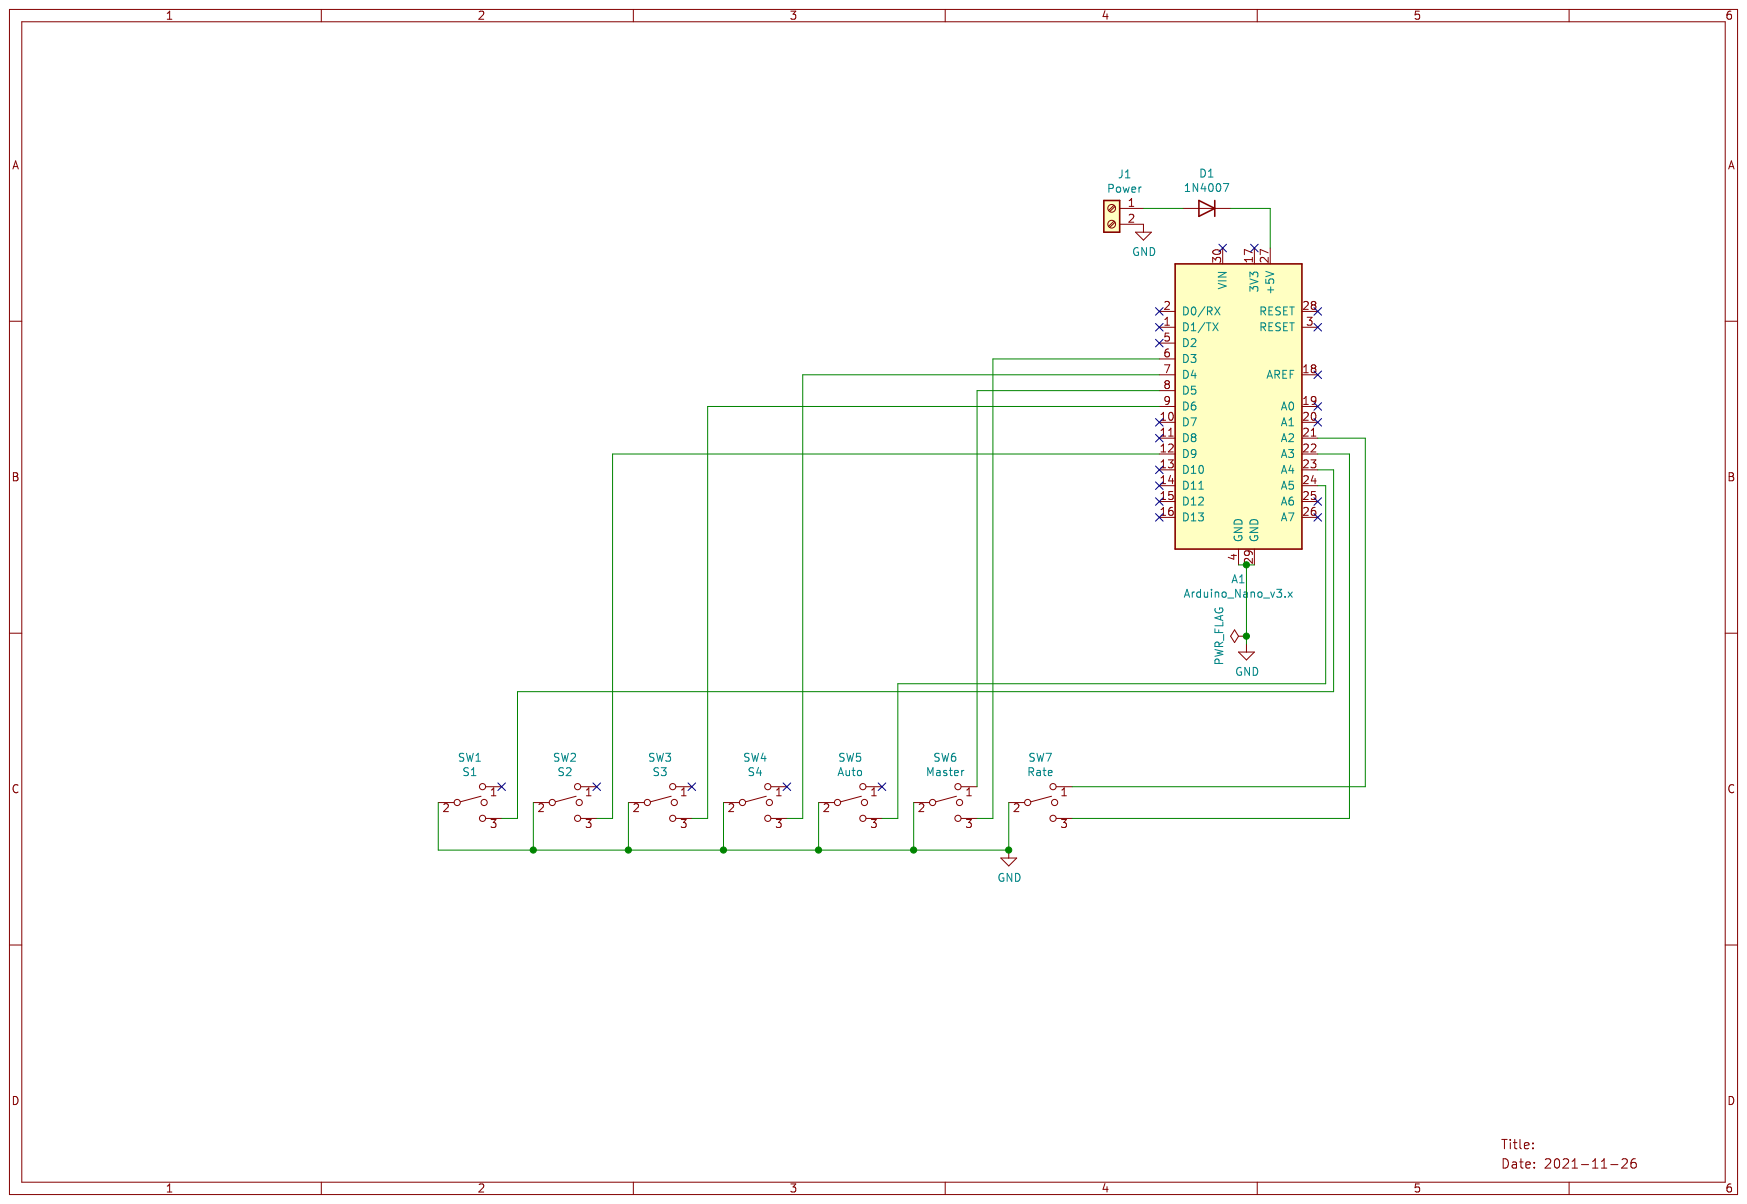
[picture p37: page 1]
