SK21/AOG_RC/Help/PCB Schematics/RC8 Schematic.pdf

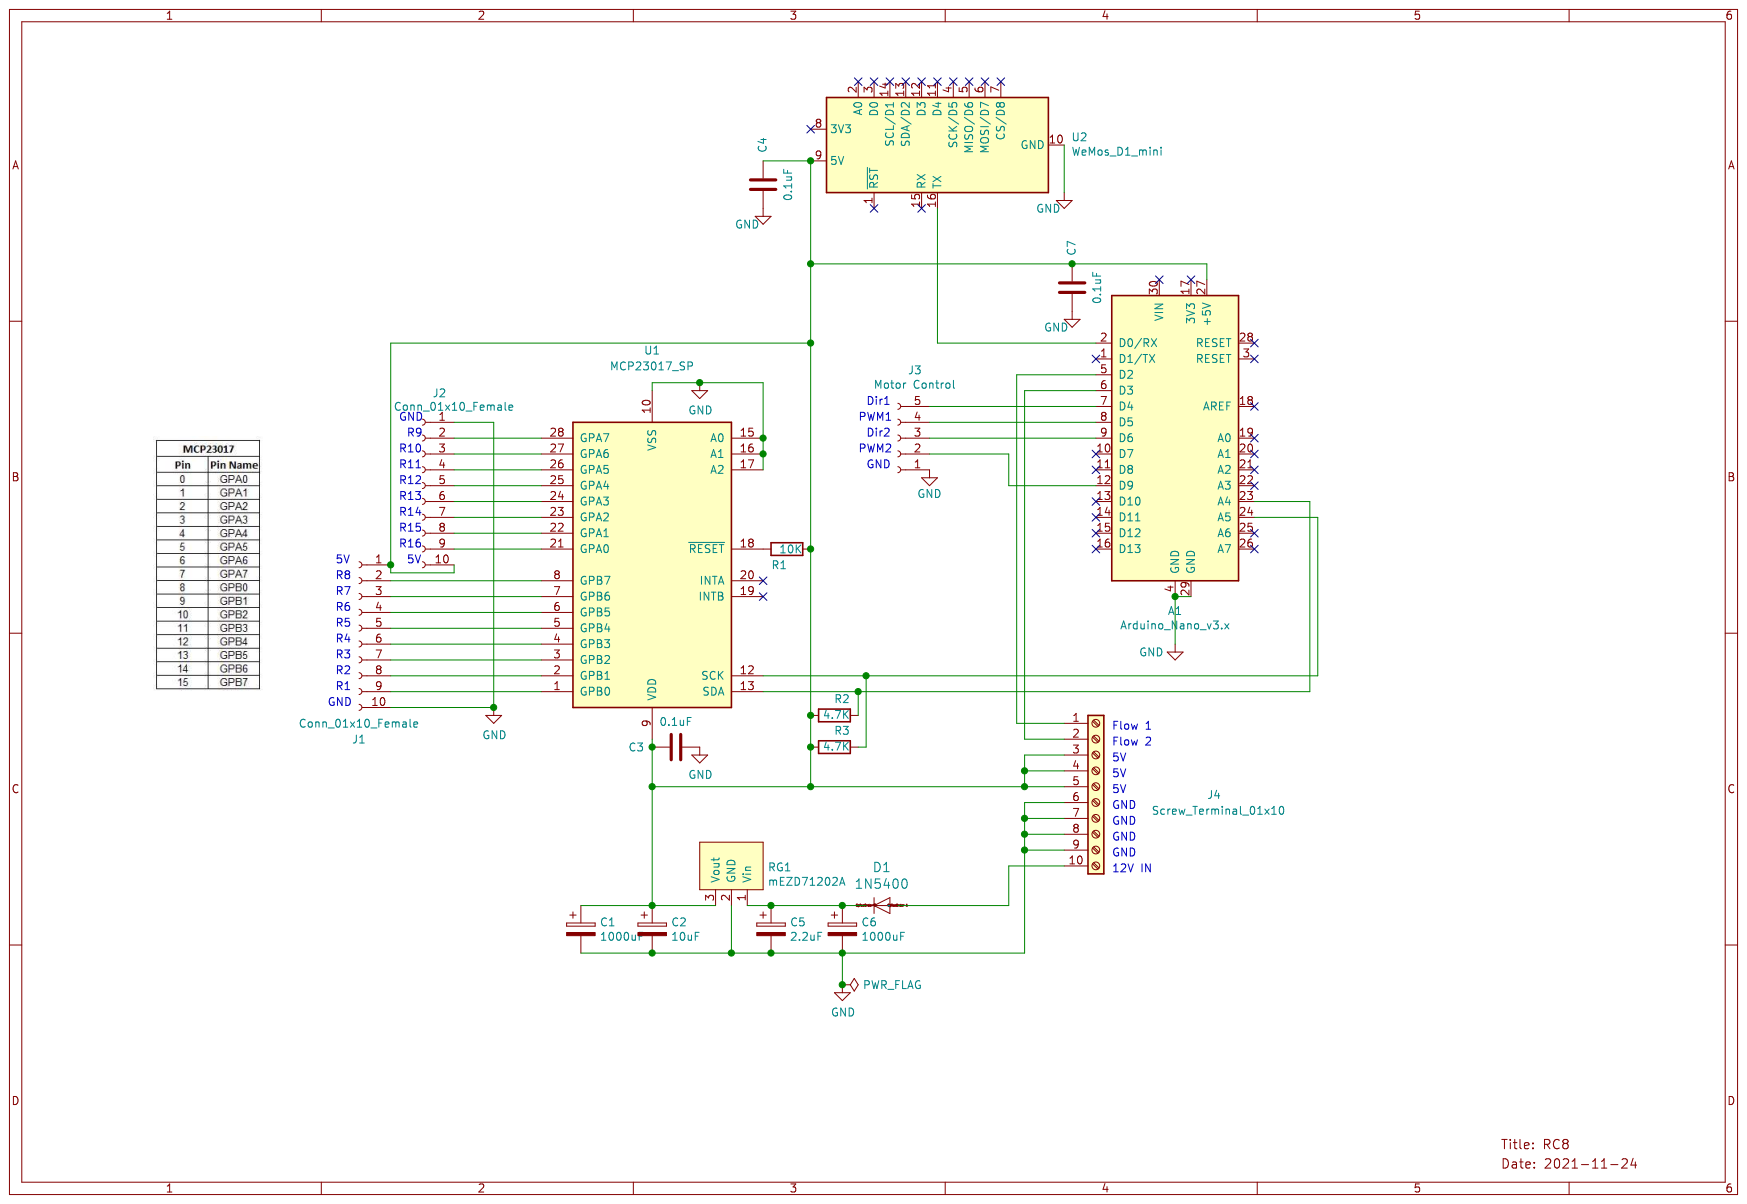
[picture p38: page 1]
