SK21/AOG_RC/Help/Relay circuits.pdf

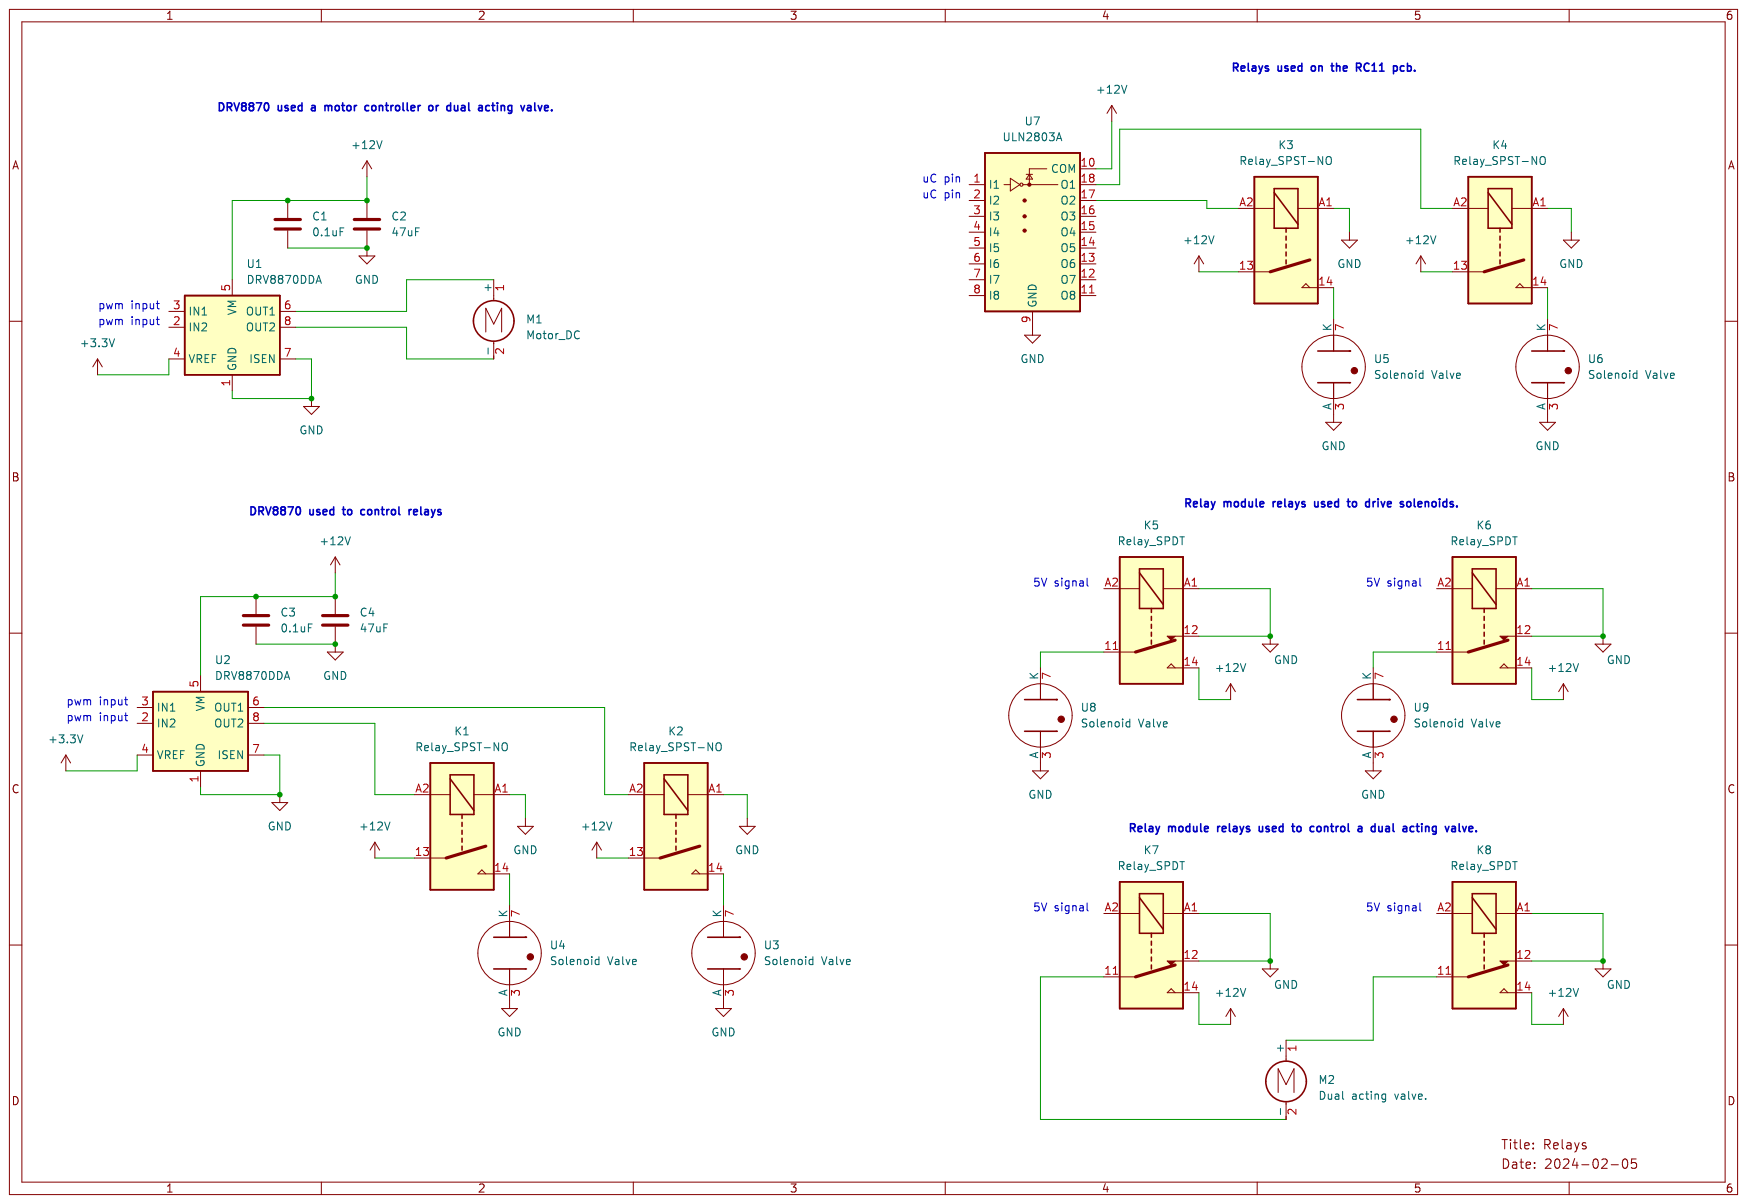
[picture p39: page 1]
