SK21/AOG_RC/PCBs/AutoSteer13_PCB/AS13.sch

## KiCad design PCBs/AutoSteer13_PCB/AS13.sch (2022-02-28)

Schematic: AS13.sch

Parts:
C1, C2, C3, C4, C5, C10, C12, C13: 0.1uF; C_0805_2012Metric
C6: 10uF; C_0805_2012Metric
C7: 22uF; C_0805_2012Metric
C8: 1uF; C_0805_2012Metric
C9: 470uF; CP_Elec_10x10.5
C11: 330uF; CP_Elec_10x10.5
D1, D2: MMSZ5231B; D_SOD-123F
D3: SS36; SMA(DO-214AC)
D4: HER505; 1N5408
D5: 1N4007; D_SMA
IC1: AZ1117; SOT-223
IC2: XL2596; TO263-5L
J1: U-USBAS04P-F000
J2: RS485; Qwic_vertical
J3: Teensy_USBhost; PinHeader_1x05_P2.54mm_Vertical
J4: HR911105A
J5: PM254V-11-06-H85; PinSocket_1x06_P2.54mm_Vertical
J6: DT13-12PA; DT1312PA; Manufacturer_Part_Number DT13-12PA; Mouser Part Number 571-DT13-12PA
J7: WemosD1_left; PinSocket_1x08_P2.54mm_Vertical
J8: Teensy_Ethernet; PinHeader_2x03_P2.00mm_Vertical
J9: WemosD1_right; PinSocket_1x08_P2.54mm_Vertical
J10, J11: I2C-3V3; Qwic_vertical
J12: CMPS14; PinSocket_1x06_P2.54mm_Vertical
J13, J17: Conn_01x15_Female; PinSocket_1x15_P2.54mm_Vertical
J14, J18: Conn_01x08_Female; PinSocket_1x08_P2.54mm_Vertical
J15: BNO080_left; PinSocket_1x08_P2.54mm_Vertical
J16: BNO080_right; PinSocket_1x08_P2.54mm_Vertical
J19: Motor 2; Qwic_vertical
J20: Motor 1; Qwic_vertical
J21: SF_F9P_left; PinSocket_1x09_P2.54mm_Vertical
J22: ArduSimple_tl; PinSocket_1x08_P2.54mm_Vertical
J23: ArduSimple_bl; PinSocket_1x06_P2.54mm_Vertical
J24: SF_F9P_right; PinSocket_1x10_P2.54mm_Vertical
J25: ArduSimple_tr; PinSocket_1x10_P2.54mm_Vertical
J26: ArduSimple_br; PinSocket_1x08_P2.54mm_Vertical
J27: Grove
K1: SRD-05VDC-SL-C; Songle_SRD-05VDC-SL-C
KF1: KF142V-5.0-2P; KF142V-5.08-2P
KF2: KF142V-5.0-6P; KF142V-5.08-6P
KF3: KF142V-5.0-4P; KF142V-5.08-4P
L1: SMDRI127-330MT; TMPA1265SP-101MN-D
Q1: BC847; SOT-23
R1, R2, R3, R6, R8: 200; R_1206_3216Metric
R4: 100; R_1206_3216Metric
R5: 120; R_1206_3216Metric
R7, R9: 400; R_1206_3216Metric
R10, R11: 2.2K; R_1206_3216Metric
R12: 1K; R_1210_3225Metric
U1: SP3485EN-L/TR; Maxim_Integrated-S8-2-0-P-MFG
U2, U3, U4, U5: PC817X2CSP9F; SOIC254P960X420-4N
U6: CC6900SO-10A; SOIC127P600X175-8N

Notes on the sheet:
Dir-22
PWM-23
Steer 2
Switch 1
Steer 1
SCL
SDA
3.3V
GND
LED
WAS (5V)
RS485 B
RS485 A
Encoder
Str Switch
Wrk Switch
Str 1
IO Ref
TX1
RX1
TX2(F9 RX)
RX2(F9 TX)
Switch 2
12V
PWM-37
DIR-36
Str 2
12V
TX2
RX2
Spd Pulse
VUSB
D_N
D_P
3V3
Can L
Can H
CRX
CTX
26 (5V)
