SK21/AOG_RC/Modules/ESP32 Rate/RC_ESP32/Begin.ino

// valid pins for each processor
uint8_t ValidPins0[] = { 0,2,4,13,14,15,16,17,21,22,25,26,27,32,33 };	// SPI pins 5,18,19,23 excluded for ethernet module


void DoSetup()
{
	uint8_t ErrorCount;

	Sensor[0].FlowEnabled = false;
	Sensor[1].FlowEnabled = false;

	Serial.begin(38400);
	delay(3000);
	Serial.println("");
	Serial.println("");
	Serial.println(BuildTypes[BuildType]);
	Serial.print("Version:    ");
	Serial.print(BuildDay);
	Serial.print("-");
	Serial.print(Months[BuildMonth - 1]);
	Serial.print("-");
	Serial.println(BuildYear + 2000);

	// eeprom
	EEPROM.begin(EEPROM_SIZE);
	LoadData();

	if (MDL.WorkPin < NC) pinMode(MDL.WorkPin, INPUT_PULLUP);

	if (MDL.SensorCount > MaxProductCount) MDL.SensorCount = MaxProductCount;

	Serial.print("Module ID:  ");
	Serial.println(MDL.ID);
	Serial.println("");

	// I2C
	Wire.begin();			// I2C on pins SCL 22, SDA 21
	Wire.setClock(400000);	//Increase I2C data rate to 400kHz

	// ADS1115
	if (MDL.ADS1115Enabled)
	{
		Serial.print("Starting ADS1115 at address ");
		Serial.println(ADS1115_Address);
		while (!ADSfound)
		{
			Wire.beginTransmission(ADS1115_Address);
			Wire.write(0b00000000);	//Point to Conversion register
			Wire.endTransmission();
			Wire.requestFrom(ADS1115_Address, 2);
			ADSfound = Wire.available();
			Serial.print(".");
			delay(500);
			if (ErrorCount++ > 10) break;
		}
		Serial.println("");
		if (ADSfound)
		{
			Serial.println("ADS1115 found.");
			Serial.println("");
		}
		else
		{
			Serial.println("ADS1115 not found.");
			Serial.println("ADS1115 disabled.");
			Serial.println("");
		}
	}

	// ethernet 
	Serial.println("Starting Ethernet ...");
	MDL.IP3 = MDL.ID + 50;
	IPAddress LocalIP(MDL.IP0, MDL.IP1, MDL.IP2, MDL.IP3);
	static uint8_t LocalMac[] = { 0x0A,0x0B,0x42,0x0C,0x0D,MDL.IP3 };

	Ethernet.init(W5500_SS);   // SS pin
	Ethernet.begin(LocalMac, 0);
	Ethernet.setLocalIP(LocalIP);
	IPAddress Mask(255, 255, 255, 0);
	Ethernet.setSubnetMask(Mask);
	IPAddress Gateway(MDL.IP0, MDL.IP1, MDL.IP2, 1);
	Ethernet.setGatewayIP(Gateway);

	delay(1500);
	ChipFound = (Ethernet.hardwareStatus() != EthernetNoHardware);
	if (ChipFound)
	{
		if (Ethernet.linkStatus() == LinkON)
		{
			Serial.println("Ethernet connected.");
		}
		else
		{
			Serial.println("Ethernet not connected.");
		}
		Serial.print("IP Address: ");
		Serial.println(Ethernet.localIP());
	}
	else
	{
		Serial.println("Ethernet hardware not found.");
	}

	Ethernet_DestinationIP = IPAddress(MDL.IP0, MDL.IP1, MDL.IP2, 255);	// update from saved data

	// UDP
	UDP_Ethernet.begin(ListeningPort);

	// sensors
	for (int i = 0; i < MDL.SensorCount; i++)
	{
		pinMode(Sensor[i].FlowPin, INPUT_PULLUP);
		pinMode(Sensor[i].IN1, OUTPUT);
		pinMode(Sensor[i].IN2, OUTPUT);

		switch (i)
		{
		case 0:
			attachInterrupt(digitalPinToInterrupt(Sensor[i].FlowPin), ISR0, RISING);
			break;
		case 1:
			attachInterrupt(digitalPinToInterrupt(Sensor[i].FlowPin), ISR1, RISING);
			break;
		}
	}

	// Relays
	switch (MDL.RelayControl)
	{
	case 1:
		// Relay GPIO Pins
		Serial.println("");
		Serial.println("Using GPIO pins for relays.");
		for (int i = 0; i < 16; i++)
		{
			if (MDL.RelayControlPins[i] < NC)
			{
				pinMode(MDL.RelayControlPins[i], OUTPUT);
			}
		}
		break;

	case 2:
	case 3:
		// PCA9555 I/O expander on default address 0x20
		Serial.println("");
		Serial.println("Starting PCA9555 I/O Expander ...");
		ErrorCount = 0;
		while (!PCA9555PW_found)
		{
			Serial.print(".");
			Wire.beginTransmission(0x20);
			PCA9555PW_found = (Wire.endTransmission() == 0);
			ErrorCount++;
			delay(500);
			if (ErrorCount > 5) break;
		}

		Serial.println("");
		if (PCA9555PW_found)
		{
			Serial.println("PCA9555 found.");

			PCA.attach(Wire);
			PCA.polarity(PCA95x5::Polarity::ORIGINAL_ALL);
			PCA.direction(PCA95x5::Direction::OUT_ALL);
			PCA.write(PCA95x5::Level::H_ALL);
		}
		else
		{
			Serial.println("PCA9555 not found.");
		}
		break;

	case 4:
		// MCP23017 I/O expander on 0x20, 0x21

		Serial.println("");
		Serial.println("Starting MCP23017 ...");

		ErrorCount = 0;
		MCP23017address = 0x21;
		while (!MCP23017_found)
		{
			// RC12-3
			Serial.print(".");
			Wire.beginTransmission(0x21);
			MCP23017_found = (Wire.endTransmission() == 0);
			ErrorCount++;
			delay(500);
			if (ErrorCount > 5) break;
		}

		if (!MCP23017_found)
		{
			ErrorCount = 0;
			MCP23017address = 0x20;
			while (!MCP23017_found)
			{
				Serial.print(".");
				Wire.beginTransmission(MCP23017address);
				MCP23017_found = (Wire.endTransmission() == 0);
				ErrorCount++;
				delay(500);
				if (ErrorCount > 5) break;
			}
		}

		Serial.println("");
		if (MCP23017_found)
		{
			Wire.beginTransmission(MCP23017address);
			Wire.write(0x00); // IODIRA register
			Wire.write(0x00); // set all of port A to outputs
			Wire.endTransmission();

			Wire.beginTransmission(MCP23017address);
			Wire.write(0x01); // IODIRB register
			Wire.write(0x00); // set all of port B to outputs
			Wire.endTransmission();

			Serial.println("MCP23017 found.");
		}
		else
		{
			Serial.println("MCP23017 not found.");
		}
		break;

	case 5:
		// PCA9685
		Serial.println("");
		Serial.println("Starting PCA9685 I/O Expander ...");
		ErrorCount = 0;
		while (!PCA9685_found)
		{
			Serial.print(".");
			Wire.beginTransmission(PCA9685Address);
			PCA9685_found = (Wire.endTransmission() == 0);
			ErrorCount++;
			delay(500);
			if (ErrorCount > 5)break;
		}

		Serial.println("");
		if (PCA9685_found)
		{
			Serial.println("PCA9685 expander found.");
			PWMServoDriver.begin();
			PWMServoDriver.setPWMFreq(200);

			pinMode(OutputEnablePin, OUTPUT);
			digitalWrite(OutputEnablePin, LOW);	//enable
		}
		else
		{
			Serial.println("PCA9685 expander not found.");
		}
		break;

	case 6:
		// PCF8574
		Serial.println("");
		Serial.println("Starting PCF8574 I/O Expander ...");
		ErrorCount = 0;
		while (!PCF_found)
		{
			Serial.print(".");
			Wire.beginTransmission(PCF8574address);
			PCF_found = (Wire.endTransmission() == 0);
			ErrorCount++;
			delay(500);
			if (ErrorCount > 5) break;
		}

		Serial.println("");
		if (PCF_found)
		{
			Serial.println("PCF8574 found.");
			PCF.begin();
		}
		else
		{
			Serial.println("PCF8574 not found.");
		}
		break;
	}

	// Wifi
	WiFi.mode(WIFI_MODE_APSTA);
	WiFi.disconnect(true);

	// Access Point
	IPAddress AP_LocalIP = IPAddress(192, 168, MDL.ID + 200, 1);
	Wifi_DestinationIP = IPAddress(192, 168, MDL.ID + 200, 255);

	uint64_t macInt = ESP.getEfuseMac();
	char macStr[18];
	sprintf(macStr, "%02llX:%02llX:%02llX:%02llX:%02llX:%02llX",
		(macInt >> 40) & 0xFF,
		(macInt >> 32) & 0xFF,
		(macInt >> 24) & 0xFF,
		(macInt >> 16) & 0xFF,
		(macInt >> 8) & 0xFF,
		macInt & 0xFF);

	String AP = MDL.APname;
	AP += "_";
	AP += String(macStr);

	WiFi.softAP(AP, MDL.APpassword, 1, 0, 2);
	delay(500);
	WiFi.softAPConfig(AP_LocalIP, AP_LocalIP, AP_Subnet);
	UDP_Wifi.begin(ListeningPort);

	Serial.println("");
	Serial.print("Access Point name: ");
	Serial.println(AP);
	Serial.print("Settings Page IP: ");
	Serial.println(AP_LocalIP);

	// web server
	Serial.println();
	Serial.println("Starting Web Server");
	server.on("/", HandleRoot);
	server.on("/page1", HandlePage1);
	server.on("/page2", HandlePage2);
	server.on("/ButtonPressed", ButtonPressed);
	server.onNotFound(HandleRoot);

	// OTA
	server.on("/myurl", HTTP_GET, []() {
		server.sendHeader("Connection", "close");
		server.send(200, "text/plain", "Hello there!");
	});

	server.begin();

	/* INITIALIZE ESP2SOTA LIBRARY */
	ESP2SOTA.begin(&server);

	Serial.println("OTA started.");

	// wifi client mode
	if (MDL.WifiModeUseStation)
	{
		// connect to network
		delay(1000);
		WiFi.onEvent(WiFiStationConnected, WiFiEvent_t::ARDUINO_EVENT_WIFI_STA_CONNECTED);
		WiFi.onEvent(WiFiGotIP, WiFiEvent_t::ARDUINO_EVENT_WIFI_STA_GOT_IP);
		WiFi.onEvent(WiFiStationDisconnected, WiFiEvent_t::ARDUINO_EVENT_WIFI_STA_DISCONNECTED);
		WiFi.begin(MDL.SSID, MDL.Password);
		Serial.println();
		Serial.println("Connecting to wifi network ...");
	}

	delay(1500);
	Serial.println("");
	Serial.println("Finished setup.");
	Serial.println("");
}

void LoadData()
{
	bool IsValid = false;
	uint8_t ID[4];
	for (int i = 0; i < 4; i++)
	{
		EEPROM.get(0 + i, ID[i]);
	}

	if (ID[0] == BuildDay && ID[1] == BuildMonth && ID[2] == BuildYear && ID[3] == BuildType)
	{
		// load stored data
		Serial.println("Loading stored settings.");
		EEPROM.get(110, MDL);

		for (int i = 0; i < MaxProductCount; i++)
		{
			EEPROM.get(300 + i * 80, Sensor[i]);
		}
		IsValid = ValidData();
		if (!IsValid)
		{
			Serial.println("Stored settings not valid.");
		}
	}

	if (!IsValid)
	{
		LoadDefaults();
		SaveData();
	}
}

void SaveData()
{
	Serial.println("Updating stored settings.");
	EEPROM.put(0, BuildDay);
	EEPROM.put(1, BuildMonth);
	EEPROM.put(2, BuildYear);
	EEPROM.put(3, BuildType);

	EEPROM.put(110, MDL);

	for (int i = 0; i < MaxProductCount; i++)
	{
		EEPROM.put(300 + i * 80, Sensor[i]);
	}
	EEPROM.commit();
}

void LoadDefaults()
{
	Serial.println("Loading default settings.");

	// RC15
	MDL.WorkPin = NC;
	MDL.PressurePin = NC;

	// default flow pins
	Sensor[0].FlowPin = 17;
	Sensor[0].IN1 = 32;
	Sensor[0].IN2 = 33;

	Sensor[1].FlowPin = 16;
	Sensor[1].IN1 = 25;
	Sensor[1].IN2 = 26;

	// default control settings
	Sensor[0].MaxPower = 255;
	Sensor[0].MinPower = 10;
	Sensor[1].MaxPower = 255;
	Sensor[1].MinPower = 10;

	// relay pins
	for (int i = 0; i < 16; i++)
	{
		MDL.RelayControlPins[i] = NC;
	}
	MDL.SensorCount = 2;
	MDL.RelayControl = 5;
	MDL.WifiModeUseStation = false;
	MDL.Is3Wire = true;
	MDL.ADS1115Enabled = true;
	MDL.InvertFlow = true;
	MDL.InvertRelay = true;
}

bool ValidData()
{
	bool Result = false;

	switch (Processor)
	{
	case 0:
		// work switch
		Result = (MDL.WorkPin == NC);
		if (!Result)
		{
			for (int j = 0; j < sizeof(ValidPins0); j++)
			{
				if (MDL.WorkPin == ValidPins0[j])
				{
					Result = true;
					break;
				}
			}
			if (!Result) break;
		}

		// pressure pin
		if (Result && MDL.PressurePin < NC)
		{
			for (int j = 0; j < sizeof(ValidPins0); j++)
			{
				if (MDL.PressurePin == ValidPins0[j])
				{
					Result = true;
					break;
				}
			}
			if (!Result) break;
		}

		if (Result)
		{
			for (int i = 0; i < MDL.SensorCount; i++)
			{

				// flow pin
				Result = false;
				for (int j = 0; j < sizeof(ValidPins0); j++)
				{
					if (Sensor[i].FlowPin == ValidPins0[j])
					{
						Result = true;
						break;
					}
				}
				if (!Result) break;

				// IN1
				Result = false;
				for (int j = 0; j < sizeof(ValidPins0); j++)
				{
					if (Sensor[i].IN1 == ValidPins0[j])
					{
						Result = true;
						break;
					}
				}
				if (!Result) break;

				// IN2
				Result = false;
				for (int j = 0; j < sizeof(ValidPins0); j++)
				{
					if (Sensor[i].IN2 == ValidPins0[j])
					{
						Result = true;
						break;
					}
				}
				if (!Result) break;
			}
		}

		if (Result && MDL.RelayControl == 1)
		{
			// check GPIOs for relays
			for (int k = 0; k < 16; k++)
			{
				Result = false;
				for (int j = 0; j < sizeof(ValidPins0); j++)
				{
					if ((MDL.RelayControlPins[k] == ValidPins0[j])
						|| (MDL.RelayControlPins[k] == NC))
					{
						Result = true;
						break;
					}
				}
				if (!Result) break;
			}
		}
		break;
	}
	GoodPins = Result;
	return Result;
}
