SK21/AOG_RC/Modules/Nano/RCnano/CheckShield.ino

// uses SPI.h 
// use 'if(ShieldFound())' before 'ether.begin(sizeof Ethernet::buffer, LocalMac, selectPin);' to prevent hang

#define ADDR_MASK        0x1F
#define ENC28J60_SOFT_RESET          0xFF
#define ENC28J60_READ_CTRL_REG       0x00
#define ESTAT            0x1D
#define ESTAT_CLKRDY     0x01

bool Fnd;
uint8_t Ecount;

bool ShieldFound()
{
    SPI.begin();

    Ecount = 0;
    Fnd = false;
    while (!Fnd)
    {
        delay(500);
        Serial.print(".");

        writeOp(ENC28J60_SOFT_RESET, 0, ENC28J60_SOFT_RESET);
        delay(2); // errata B7/2
        Fnd = readOp(ENC28J60_READ_CTRL_REG, ESTAT) & ESTAT_CLKRDY;

        Ecount++;
        if (Ecount > 5) break;
    }
    return Fnd;
}

static void writeOp(byte op, byte address, byte data) {
    enableChip();
    xferSPI(op | (address & ADDR_MASK));
    xferSPI(data);
    disableChip();
}

static void enableChip() {
    cli();
    digitalWrite(selectPin, LOW);
}

static void xferSPI(byte data) {
    SPDR = data;
    while (!(SPSR & (1 << SPIF)))
        ;
}

static void disableChip() {
    digitalWrite(selectPin, HIGH);
    sei();
}

static byte readOp(byte op, byte address) {
    enableChip();
    xferSPI(op | (address & ADDR_MASK));
    xferSPI(0x00);
    if (address & 0x80)
        xferSPI(0x00);
    byte result = SPDR;
    disableChip();
    return result;
}
