SK21/AOG_RC/(commit log)

2019-12-11 minor changes
    [AutoSteer6.kicad_pcb, AutoSteer6.sch, Info.xls, Parts.xls]
2019-12-21 update section switches code and other fixes
    [Comm.ino, Motor.ino, RateSwitches.ino, SectionSwitches.ino, Simulate.ino]
2019-12-22 update pcb
    [AutoSteer.xls, AutoSteer6.kicad_pcb, AutoSteer6.sch, Info.xls, Parts.xls]
2019-12-22 added Sparkfun Razor IMU
2019-12-22 added USFS IMU
2020-02-12 reorganized folders
    [AutoSteer.xls, AutoSteer6.kicad_pcb, AutoSteer6.sch, Info.xls, Parts.xls, RC31.kicad_pcb, RC31.sch, Switches.kicad_pcb]
2020-03-08 reorganized files
    [2019_10_10_13_42.xlsx, AOG_pgn.xls, AutoSteer.xls, AutoSteer6.kicad_pcb, AutoSteer6.sch, Info.xls, Parts.xls, RC31.kicad_pcb]
2020-03-08 Version 4 with rate control
    [2019_10_10_13_42.xlsx, AOG_pgn suggestion 2020-02-12.xlsx, AOG_pgn.xls, AutoSteer.xls, AutoSteer6.kicad_pcb, AutoSteer6.sch, Info.xls, Parts.xls]
2020-03-09 Updated rate calculations
    [AOG_pgn.xls]
2020-03-12 rate control for latest V4 10Mar2020
    [AOG_pgn.xls]
2020-03-15 rate controller plug-in
    [2019_10_10_13_42.xlsx, AOG_pgn suggestion 2020-02-12.xlsx]
2020-03-23 rate control for V4.1 23Mar2020
    [2019_10_10_13_42.xlsx, AOG_pgn suggestion 2020-02-12.xlsx]
2020-03-26 changed rate calculation
    [AOG_PGNs.xls]
2020-03-29 virtual nano for testing, pcb gerbers, updated rate code again
    [AOG_PGNs.xls, Info.xls, Parts.xls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]
2020-03-31 Adjustment Factor, Average Rate (click on Current Rate)
2020-04-03 fixed bug with unsigned int header variable
    [SerialComm.ino, Simulate.ino, UDPwifiComm.ino]
2020-04-06 Remove old code
    [2019_10_10_13_42.xlsx, AOG_pgn suggestion 2020-02-12.xlsx, AOG_pgn.xls, AutoSteer.xls, AutoSteer6.kicad_pcb, AutoSteer6.sch, Info.xls, Parts.xls]
2020-04-06 another unsigned int bug, added quantity validity check
    [SerialComm.ino, UDPwifiComm.ino]
2020-04-09 minor bug fixes
    [AOG_PGNs.xls]
2020-04-09 support for some module configuration, imu pgn changes
2020-04-09 takes IMU data from the serial port and sends to AgOpenGPS
2020-04-10 unsigned int bug, other fixes
    [HeadingRoll.ino, SerialComm.ino, Steering.ino, Switches.ino, UDPwiredComm.ino]
2020-04-19 arduino sketch to check WAS and switches
2020-04-20 fixed bug with simulator off
    [Parts.xls]
2020-04-30 fixed bug in wifi comm
    [UDPwifiComm.ino]
2020-05-01 changed PGNs
    [AOG_PGNs.xls]
2020-05-02 pin for relay to release steering motor
2020-06-04 removed PID control and added VCN control
    [AOG_PGNs.xls, Info.xls]
2020-06-04 Nano only PCB
    [RC4-B_Cu.gbr, RC4-B_Mask.gbr, RC4-B_Paste.gbr, RC4-B_SilkS.gbr, RC4-Edge_Cuts.gbr, RC4-F_Cu.gbr, RC4-F_Mask.gbr, RC4-F_Paste.gbr]
2020-06-07 updated arduino sketch for LOW_HIGH_DEGREES
2020-06-07 Updated to 22May2020 release
    [2019_10_10_13_42.xlsx, AOG_pgn suggestion 2020-02-12.xlsx]
2020-07-13 fixed prototype bug, added steering angle limit
    [HeadingRoll.ino, PID.ino, Steering.ino]
2020-07-13 added Kalmen Filter to flow rate
2020-07-17 worksheet to visualize Kalman settings
    [KalmanFilter.xls]
2020-08-22 update flow cals
2020-10-08 added rate smoothing, added Kalmen filter to GPS speed
2020-10-11 removed steering angle limit, clean-up code
2021-01-01 Rate Comm error, Wired UDP settings, misc. errors
    [SerialComm.ino, Simulate.ino, UDPwifiComm.ino, UDPwiredComm.ino]
2021-01-27 New version, up to 5 products controlled at a time
    [2019_10_10_13_42.xlsx, AOG_PGNs.xls, AOG_pgn suggestion 2020-02-12.xlsx]
2021-01-29 added PID back in as an option
    [AOG_PGNs.xls]
2021-02-09 added calibration tab, section widths, only require speed & sections PGN
2021-02-12 update UPM cal for low/high count sensor, added rpm display
2021-03-15 Compatible with AOG 4.6
    [AutoSteer.xls, AutoSteer6.kicad_pcb, AutoSteer6.sch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]
2021-03-30 added arduino files
2021-03-30 fix applied amount totaling
    [Rate.ino]
2021-04-01 Send switch IDs to arduino
2021-04-01 added support for wifi switches
2021-04-01 Wifi switches code for Wemos D1 Mini
2021-04-16 Added option to use Nano for relays instead of MCP23017.
2021-05-02 AOG on-screen section buttons work when RC is in manual.
2021-06-06 Removed VCN, fixed manual rate bug, added optional rate method
    [Motor.ino, SerialComm.ino, UDPwifiComm.ino, UDPwiredComm.ino]
2021-06-19 remove AOG area matching, added defines for pre-built relay in ino
2021-11-05 Teensy 4.1, PCB 7, vr data, pressure monitoring
2021-11-20 Revert "Teensy 4.1, PCB 7, vr data, pressure monitoring"
    This reverts commit 453a0edcac53926f46f1fa3af2a1ce5cb2e6e057.
    [Motor.ino, PID.ino, Rate.ino, Relays.ino, SerialComm.ino, Simulate.ino, Switches.ino, UDPwifiComm.ino]
2021-11-28 Added PCBs
    [RC5-B_Cu.gbr, RC5-B_Mask.gbr, RC5-B_Paste.gbr, RC5-B_SilkS.gbr, RC5-Edge_Cuts.gbr, RC5-F_Cu.gbr, RC5-F_Mask.gbr, RC5-F_Paste.gbr]
2021-12-29 Test steer/rate board
    [AS12-Computer1.kicad_pcb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]
2021-12-30 16 sections switches, improved rate cal, changed settings pages
    [SW2-B_Cu.gbr, SW2-B_Mask.gbr, SW2-B_Paste.gbr, SW2-B_SilkS.gbr, SW2-Edge_Cuts.gbr, SW2-F_Cu.gbr, SW2-F_Mask.gbr, SW2-F_Paste.gbr]
2022-01-07 update pcb/software
    [AS12-Computer1.kicad_pcb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]
2022-01-07 add sticky relay messages
2022-01-13 fix board errors
    [AS12-B_Cu.gbr, AS12-B_Mask.gbr, AS12-B_Paste.gbr, AS12-B_SilkS.gbr, AS12-Edge_Cuts.gbr, AS12-F_Cu.gbr, AS12-F_Mask.gbr, AS12-F_Paste.gbr]
2022-01-25 fix rate averaging error
    [RCnano.ino, Rate.ino]
2022-01-29 fixed remote switches
    [AS12-B_Cu.gbr, AS12-B_Mask.gbr, AS12-B_Paste.gbr, AS12-B_SilkS.gbr, AS12-Edge_Cuts.gbr, AS12-F_Cu.gbr, AS12-F_Mask.gbr, AS12-F_Paste.gbr]
2022-01-31 Changed relay
    [AS12fab.xls]
2022-02-13 fix comm data variables
    [Relays.ino, Steering.ino]
2022-02-13 fixed I2C connection
    [AS12-B_Cu.gbr, AS12-B_Mask.gbr, AS12-B_Paste.gbr, AS12-B_SilkS.gbr, AS12-Edge_Cuts.gbr, AS12-F_Cu.gbr, AS12-F_Mask.gbr, AS12-F_Paste.gbr]
2022-02-28 design fixes, remove ads, add CAN, add host usb, add adafruit BNO
    [AS13-B_Cu.gbr, AS13-B_Mask.gbr, AS13-B_Paste.gbr, AS13-B_SilkS.gbr, AS13-Edge_Cuts.gbr, AS13-F_Cu.gbr, AS13-F_Mask.gbr, AS13-F_Paste.gbr]
2022-03-02 renamed and updated code for AS12-2 pcb.
2022-03-03 added steer data 2
2022-03-05 rename pcb folders
    [AS12-B_Cu.gbr, AS12-B_Mask.gbr, AS12-B_Paste.gbr, AS12-B_SilkS.gbr, AS12-Edge_Cuts.gbr, AS12-F_Cu.gbr, AS12-F_Mask.gbr, AS12-F_Paste.gbr]
2022-03-12 fix variable definition errors
    [Rate.ino, Relays.ino, Steering.ino]
2022-03-17 added BAV99 to analog pins
    [AS13-B_Cu.gbr, AS13-B_Mask.gbr, AS13-B_Paste.gbr, AS13-B_SilkS.gbr, AS13-Edge_Cuts.gbr, AS13-F_Cu.gbr, AS13-F_Mask.gbr, AS13-F_Paste.gbr]
2022-03-22 reorganize to a Master and Dev branch
    [AS12fab.xls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]
2022-03-22 add dev files
    [AS12-B_Cu.gbr, AS12-B_Mask.gbr, AS12-B_Paste.gbr, AS12-B_SilkS.gbr, AS12-Edge_Cuts.gbr, AS12-F_Cu.gbr, AS12-F_Mask.gbr, AS12-F_Paste.gbr]
2022-06-12 update to 2.3.0
    [AS13-B_Cu.gbr, AS13-B_Mask.gbr, AS13-B_Paste.gbr, AS13-B_SilkS.gbr, AS13-Edge_Cuts.gbr, AS13-F_Cu.gbr, AS13-F_Mask.gbr, AS13-F_Paste.gbr]
2022-06-13 fix bracket error in SerialComm
    [RCnano.ino, SerialComm.ino]
2022-06-25 Teensy hex file, actuator
2022-06-25 actuator, rate control update
2022-06-25 AS13 pcb pictures
2022-06-25 pcb to control relay module using a Qwiic connector
    [BOM.xls, PickAndPlace_RelayDriver_2022-03-16.csv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]
2022-06-29 add integral, fix low max
    [PID.ino, RCnano.ino, SerialComm.ino, UDPwiredComm.ino]
2022-07-12 hex files, serial monitor, serial imu
2022-07-12 serial imu, Serial1Comm
2022-07-16 serial comm pgn length, actuator motion
2022-07-17 pgnlength, nano relays
2022-09-23 AutoSteer 14 pcb
    [AS14-B_Cu.gbr, AS14-B_Mask.gbr, AS14-B_Paste.gbr, AS14-B_SilkS.gbr, AS14-Edge_Cuts.gbr, AS14-F_Cu.gbr, AS14-F_Mask.gbr, AS14-F_Paste.gbr]
2022-09-23 remove 3d models
    [AS14.kicad_pcb]
2022-09-23 ADS1115, TB6612 motor driver
2022-11-09 3d printed enclosure for AS14
    [AS14 box v18.3mf, AS14 box v18.stl]
2022-11-28 Teensy rate module
    [Analog.sch, BOM.xls, ESP8266.sch, Ethernet.sch, Flow.sch, PickAndPlace_RC10_2022-11-19.csv, Power.sch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]
2022-11-28 Wifi connection, pressures
2022-12-02 rename folder
    [AS12-B_Cu.gbr, AS12-B_Mask.gbr, AS12-B_Paste.gbr, AS12-B_SilkS.gbr, AS12-Edge_Cuts.gbr, AS12-F_Cu.gbr, AS12-F_Mask.gbr, AS12-F_Paste.gbr]
2022-12-02 steer version with no rate
2022-12-15 USB host to connect to switchbox
2022-12-27 remove for testing
    [Analog.sch, BOM.xls, ESP8266.sch, Ethernet.sch, Flow.sch, PickAndPlace_RC10_2022-11-19.csv, Power.sch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]
2023-01-03 network settings, weight, pgns, calibration
2023-01-06 Created Fan-Density to attempt to merge the density changes into the fan changes.
2023-01-07 Merged Density into Fan. When density is enabled and virtual nano is used there is erronious values returned for UPM applied.
2023-01-10 fix data conversion errors
    [RCnano.ino, SerialComm.ino, UDPwiredComm.ino]
2023-01-10 remove pwm X 10
2023-01-10 update comm
    [RC8.xls]
2023-01-10 fix RateController with no switchbox
2023-01-11 increase decimal precision
    fix RateController with no switchbox
    Corrected application of density to rates and UPM calculations.
    Squashed these three commits together
2023-01-12 Lowered delay on flow inputs to 3 from 10 Fixed bit shift in serialcom.ino
    [Rate.ino, SerialComm.ino]
2023-01-14 update Teensy for fan and debounce
2023-01-29 fix master switch with no switchbox
    [RCnano.ino, UDPwiredComm.ino]
2023-01-30 changed the fan ui
2023-01-30 fixed fan settings display
2023-01-30 updated Teensy PID, Rate
2023-01-30 added Alarm button to large screen
2023-01-31 moved RelayDriver, updated icons
    [BOM.xls, PickAndPlace_RelayDriver_2022-03-16.csv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]
2023-01-31 fixed restart bug, updated icons
    [RCnano.ino]
2023-02-01 fixed pid not being sent
    [Comm.ino, PID.ino, RCnano.ino, SerialComm.ino]
2023-02-02 update calibration code
2023-02-02 fix fan setting page
    [RCnano.ino]
2023-02-02 fix unique pair for module/sensor ID
2023-02-05 fixed manual rate for negative values, added a byte to 32614
    [PID.ino, RCnano.ino, SerialComm.ino, UDPwiredComm.ino]
2023-02-05 update Teensy for pgn 32614
2023-02-06 fix teensy comm, pid
    [Comm.ino, PID.ino, RCnano.ino, RCteensy.ino, Relays.ino, SerialComm.ino, UDPwiredComm.ino]
2023-02-06 RC11 PCB
    [Analog.kicad_sch, Analog.sch, BOM.xls, ESP8266.kicad_sch, ESP8266.sch, Ethernet.kicad_sch, Ethernet.sch, Flow.sch]
2023-02-07 update PCBsetup
2023-02-07 fix pgn32500 storage location
    [Comm.ino, RCteensy.ino]
2023-02-10 fix teensy comm, Integral, eeprom, WifiAOG udp
    [Comm.ino, PID.ino, RCteensy.ino, WifiAOG.ino]
2023-02-15 fix reset code, fan button
    [Comm.ino, RCteensy.ino, WifiAOG.ino]
2023-02-18 fix relay control, update hex files
    [RCnano.ino, Relays.ino, UDPwiredComm.ino]
2023-02-19 PCBsetup help, longer com names
2023-03-10 fix struct default values
    [RCnano.ino, RCteensy.ino, SerialComm.ino]
2023-03-11 fix Teensy struct defaults
    [Begin.ino, RCnano.ino]
2023-03-11 Revert "fix Teensy struct defaults"
    This reverts commit 9df23a096588b070bead45d58ee5ca06bc510636.
    [Begin.ino, RCnano.ino]
2023-03-22 Revert "nano rate changes"
    This reverts commit b7a0b2a2af70d530ecbb35e5e071c5635260f6c1.
    [Rate.ino]
2023-03-24 fix pid errorpercent, change gain
    [PID.ino, RCnano.ino]
2023-03-24 update Teensy rate for errorpercent and gain
    [PID.ino, RCteensy.ino]
2023-03-24 pid code, hex files update
2023-03-24 fixed variable type for pwmSetting in RCnano.ino
    [RCnano.ino]
2023-03-25 fix Teensy rate pwmSetting variable
    [RCteensy.ino]
2023-03-29 added wait for counts, reset Oave
    [RCnano.ino, Rate.ino]
2023-03-29 Fan Rate display mode
2023-04-01 Added Bump Buttons. Added "Auto/Master" button. Added minimize button with a restore button. Made it so the form flashes if you click on the form itself instead of a control in transparent mode. Chan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
2023-04-01 fix calibration code
2023-04-01 fix calibration accumulated quantity, time span
2023-04-03 edited bump buttons for manual rate
2023-04-03 Update Teensy rate code
2023-04-16 update steering eeprom, congfig
2023-04-17 fix imu selection
2023-04-19 Remove Autosteer files
    [AS12-B_Cu.gbr, AS12-B_Mask.gbr, AS12-B_Paste.gbr, AS12-B_SilkS.gbr, AS12-Edge_Cuts.gbr, AS12-F_Cu.gbr, AS12-F_Mask.gbr, AS12-F_Paste.gbr]
2023-04-19 Revert "Remove Autosteer files"
    This reverts commit d4af38807c78b949e62d5e5656c8bcf2631a2aa7.
    [AS12-B_Cu.gbr, AS12-B_Mask.gbr, AS12-B_Paste.gbr, AS12-B_SilkS.gbr, AS12-Edge_Cuts.gbr, AS12-F_Cu.gbr, AS12-F_Mask.gbr, AS12-F_Paste.gbr]
2023-04-19 Moved PCBsetup to its own repository.
2023-04-19 Moved Teensy Steer to AOG_AutoSteer
    [AS12-B_Cu.gbr, AS12-B_Mask.gbr, AS12-B_Paste.gbr, AS12-B_SilkS.gbr, AS12-Edge_Cuts.gbr, AS12-F_Cu.gbr, AS12-F_Mask.gbr, AS12-F_Paste.gbr]
2023-06-11 update teensy rate, comm
2023-06-13 remove save sensor
2023-06-25 fix isr over buffer
    [RCnano.ino, Rate.ino, UDPwiredComm.ino]
2023-06-25 fix isr buffer overflow
    [Comm.ino, RCteensy.ino, Rate.ino]
2023-06-25 RC12 pcb
    [BOM-RC12.csv, BOM-RC12.xls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]
2023-06-27 fix wifi module reconnect
    [Analog.ino, Comm.ino, GUI.ino, OTA.ino, WifiRC.ino]
2023-11-29 update Teensy subnet change
2023-12-09 Combine ChangePGNs branch
    [BOM-RC12.xls]
2023-12-10 fix switches
2023-12-19 switches persistance
2023-12-20 update switches
2023-12-26 fix switch code
2023-12-28 update teensy hex file
2023-12-30 update teensy pgns
2024-01-03 switchbox work switch pin
2024-01-04 add Mask to ethernet, fix ap mode
    [Begin.ino, RC_ESP32.ino, UDPComm.ino, WifiComm.ino]
2024-01-05 OTA using ESP32 AP mode
2024-01-07 fix interrupts
2024-01-07 pressure display form
2024-01-10 update valve control
2024-01-10 update valve adjust
2024-01-11 save CalPWM, manual pwm match auto when not used
2024-01-13 fix fan settings
2024-01-25 remove files
    [Analog.kicad_sch, Analog.sch, BOM-RC12.csv, BOM-RC12.xls, BOM.xls, ESP8266.kicad_sch, ESP8266.sch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]
2024-01-25 add ISR prototypes
2024-01-26 define pin not connected
2024-01-26 Revert "define pin not connected"
    This reverts commit 8486cf2079518dd860acb308701a4b947e3334f9.
    [RCteensy.ino, Relays.ino]
2024-01-26 Revert "define pin not connected"
    This reverts commit 3fb47acbc0c88d0201eab5736e0f32f1ccfea9d6.
    [RCnano.ino, Relays.ino]
2024-01-26 Revert "define pin not connected"
    This reverts commit f8a16ca0f3c2ab09e962fd9046d9095e6f7f8790.
    [RC_ESP32.ino, Relays.ino]
2024-02-04 update pressure dialog
2024-02-04 fix inverted relays
2024-02-05 update relay control types
2024-02-09 user-defined primed switch delay
2024-02-15 fix calibrate, PrimedStart, switches, add vr
2024-02-16 fix primedstart cancel button
2024-02-16 update ESP32 code for PCF8574
2024-02-16 remove arduino sim
2024-02-19 check pin configuration
2024-02-22 add esp32 client mode
2024-02-22 fix comm diagnostic page
    [RC_ESP32.ino]
2024-02-29 fix multi-module relays
2024-03-05 work switch, separate auto rate/sections, new menu
2024-03-10 remove relay event from PGN254
2024-03-15 change pid scaling
2024-03-15 pwm is remembered when master switched
2024-03-20 release button added to large screen
2024-03-20 PID scaling pgn
2024-03-25 clean-up pid code
2024-03-28 remove unused pid code
2024-03-28 momentary work pin
2024-03-28 momentary work switch
2024-03-30 update PID example as typed
2024-03-30 fix master switch/work switch combo
2024-03-30 read master switch position
2024-03-31 update doubles, work pin, rate, pid
2024-04-01 Hz, scale PID to match
2024-04-01 fix section switches above 8
2024-04-08 fix master relay
2024-04-09 relays fixed for connection loss
    [RCnano.ino, Relays.ino]
2024-04-09 master relay support
2024-04-09 PWM frequency change
2024-04-21 fix switchbox save data
    [Receive.ino, SWarduino.ino]
2024-04-23 update teensy hex
2024-04-27 fix valve pid, send pwm
    [PID.ino, RCteensy.ino, Receive.ino, Send.ino]
2024-04-27 fix pid and send comm for nano rate
    [PID.ino, RCnano.ino, Send.ino]
2024-04-29 update raven flowmeter
2024-04-29 fix teensy rate hex
2024-05-01 add schottky diode help
2024-05-17 update for timed valve
2024-05-17 update pid for timed valve
2024-05-17 add valve help
2024-05-20 add switches
2024-05-21 hook up switches
2024-05-21 connect to relays
2024-06-05 fix switching profiles
2024-06-09 fix pin pgn receive
    [Receive.ino, SWarduino.ino]
2024-06-11 change board config
2024-06-15 large screen two buttons
2024-06-16 large screen copy product 0, buttons fix
2024-06-23 add AltISR button
2024-06-26 fix module config relay pin entry
2024-07-02 fix module relay pin entry
2024-11-13 add rate and pid
2024-11-20 test pid, rate
2024-11-24 update pressure display
2024-11-25 update rc esp32
2024-11-26 update modules, pgn changes, pid, rate
2024-12-01 SonarQube updates
2024-12-02 resize pressure display
2024-12-03 update relays
2024-12-21 ino brake settings
2024-12-24 update pid
2024-12-24 add tank reset button
2024-12-29 remove auto switch, remove serial support
2024-12-29 remove single auto switch
2024-12-29 switchbox indicator
2025-01-06 update forms on switch
2025-01-07 button highlights
2025-01-09 fix calibration page
2025-01-09 fix error percent, add switchbox indicator
2025-01-10 2 options for auto switch
2025-01-11 remove switches dgv
2025-01-11 fix fan display
2025-01-20 attach MapManger
2025-01-26 update help files
    [AOG_RC_Language.xls]
2025-02-24 Update master switch
2025-02-27 multiple polygons to fix holes
2025-03-12 update pressure reading
2025-03-13 pressure form
2025-03-13 add pressure help
2025-03-17 filter applied layers
2025-03-17 add applied button
2025-03-18 add Props class
2025-03-19 more props
2025-03-21 fix pca9685 relay control
    [Begin.ino, Motor.ino, PID.ino, RC_ESP32.ino, Relays.ino, UDPComm.ino]
2025-03-21 fix esp32 firmware
2025-03-21 test pwm
2025-03-23 update class prop
2025-03-30 update teensy defaults
2025-03-30 fix print map
2025-03-30 polygon edit button
2025-04-01 fix mcp23017 relay control
    [Begin.ino, RCnano.ino, Receive.ino, Relays.ino]
2025-04-02 fix pressure display
2025-04-02 fix esp32 pressure
2025-04-02 update pressure help
2025-04-05 fix pid
2025-04-13 fix switchbox auto pin
    [Receive.ino, SWarduino.ino]
2025-04-20 fix hz, update Rate.ino
    [PID.ino, RC_ESP32.ino, RCnano.ino, RCteensy.ino, Rate.ino, Send.ino, UDPComm.ino]
2025-04-20 fix 32400, update wifi credential code, fix save credentials
    [RC_ESP32.ino, RCteensy.ino, Rate.ino, Send.ino, UDPComm.ino]
2025-05-17 integral for teensy
2025-05-18 pressure zero minimum, update help
2025-05-24 update syntax errors, increase Ki, add flow enabled check
    [PID.ino, RC_ESP32.ino, Rate.ino, UDPComm.ino]
2025-05-25 update relay help
2025-05-28 add left click move, pins, move pressure on full screen
2025-06-03 update integral, provide pwm feedback
2025-06-04 Revert "update integral, provide pwm feedback"
    This reverts commit dc5528fc63e1827f31c54a46526eb3cdd4911d26.
    [PID.ino, RCnano.ino, RCteensy.ino, Send.ino]
2025-06-04 fix pid pgn
2025-06-04 change pid pgn update frequency
2025-06-12 add range buttons to product control
2025-06-12 update pid and rate
2025-06-21 change max valve integral
2025-06-23 minimum 1 Hz flow sensor
2025-06-27 use a6 and a7 as switches
2025-07-01 change max valve integral increase
2025-07-14 switchbox date, version current dates
2025-07-15 add serial setup to switchbox
